MeshPointWifi/MeshPoint/Photos/MeshPoint Winter Test Beta Testing.jpg

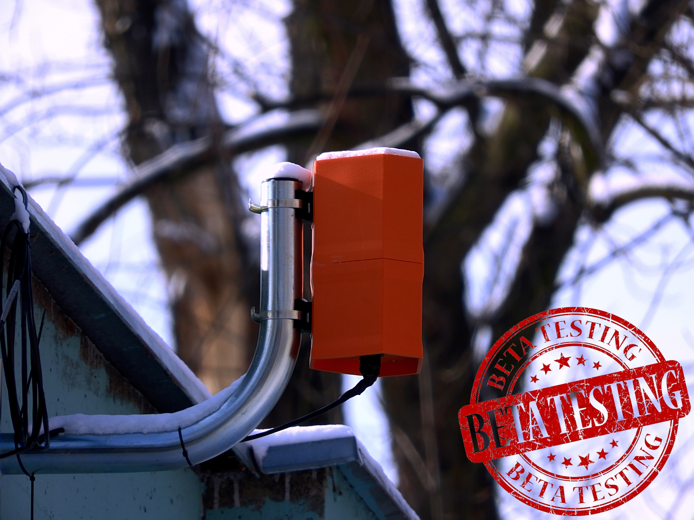
Photos/MeshPoint Winter Test Beta Testing.jpg
