MeshPointWifi/MeshPoint/Photos/Prototype V2/MeshPoint Winter Test Hand Approved.jpg

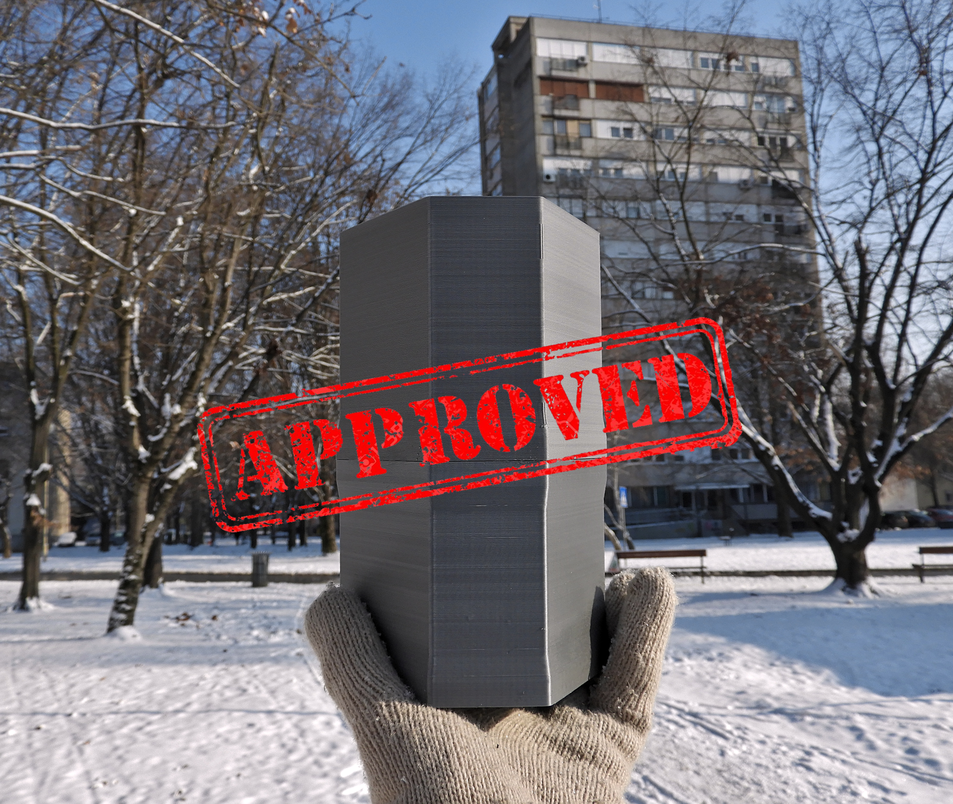
Photos/Prototype V2/MeshPoint Winter Test Hand Approved.jpg
