MeshPointWifi/MeshPoint/README.md

# MeshPoint
MeshPoint is Open source Wifi Hotspot for Crisis Situations
www.meshpointone.com

## Licence

This project (hardware designs, 3D files and documentation) is released under the
**CERN Open Hardware Licence Version 2 - Strongly Reciprocal (CERN-OHL-S v2)**.

See the [LICENCE](LICENCE) file for the full text.
More info: https://cern-ohl.web.cern.ch/
