MeshPointWifi/MeshPoint/Photos/2015-09-20 Tovarnik Refugee Center/20150921_183841.jpg

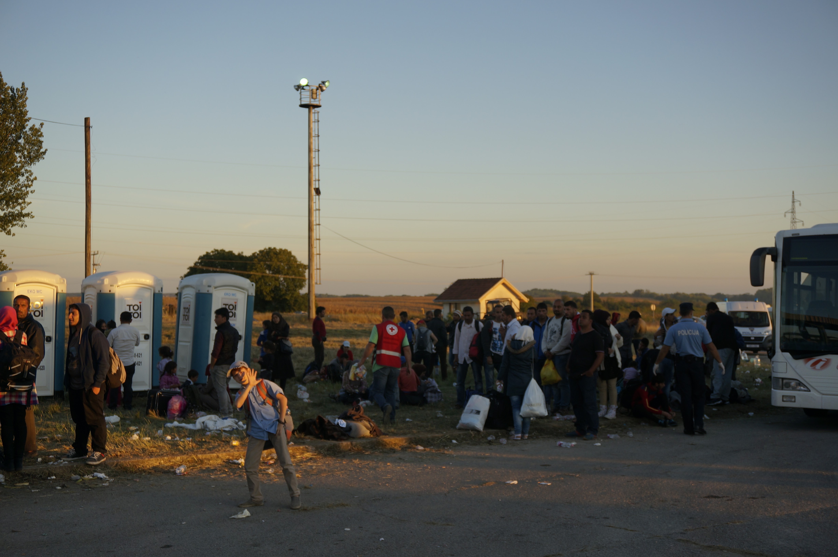
Photos/2015-09-20 Tovarnik Refugee Center/20150921_183841.jpg
