MeshPointWifi/MeshPoint/Photos/2015-09-20 Tovarnik Refugee Center/IMG_3982-COLLAGE.jpg

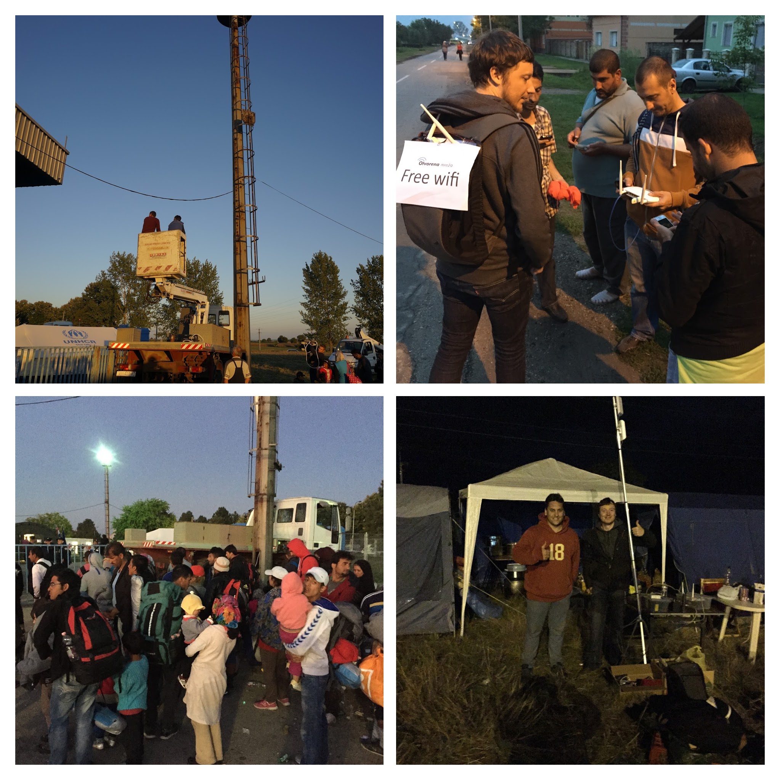
Photos/2015-09-20 Tovarnik Refugee Center/IMG_3982-COLLAGE.jpg
