MeshPointWifi/MeshPoint/Photos/2015-09-20 Tovarnik Refugee Center/IMG_3986.PNG

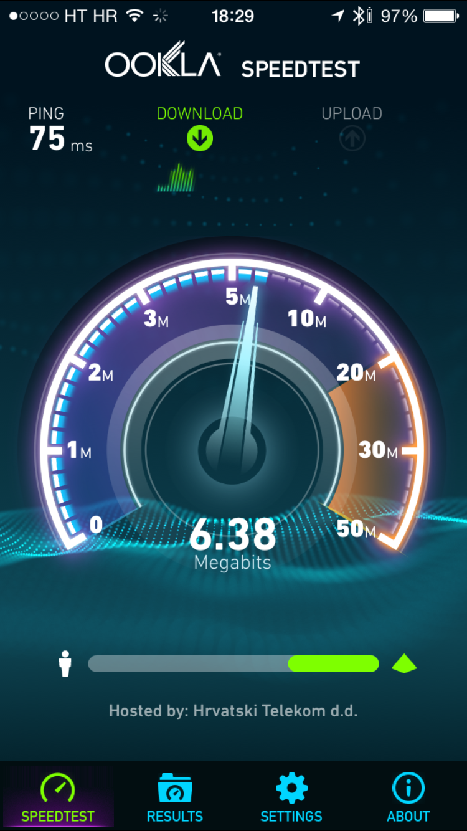
Photos/2015-09-20 Tovarnik Refugee Center/IMG_3986.PNG
