MeshPointWifi/MeshPoint/Photos/2015-09-20 Tovarnik Refugee Center/IMG_4061.JPG

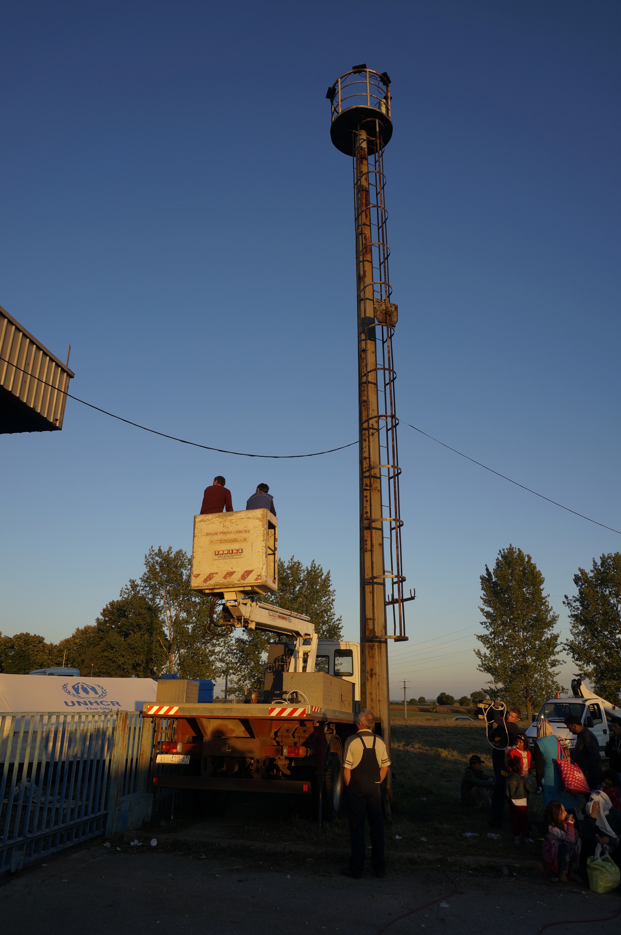
Photos/2015-09-20 Tovarnik Refugee Center/IMG_4061.JPG
