MeshPointWifi/MeshPoint/Photos/2015-09-20 Tovarnik Refugee Center/IMG_20150922_123130.jpg

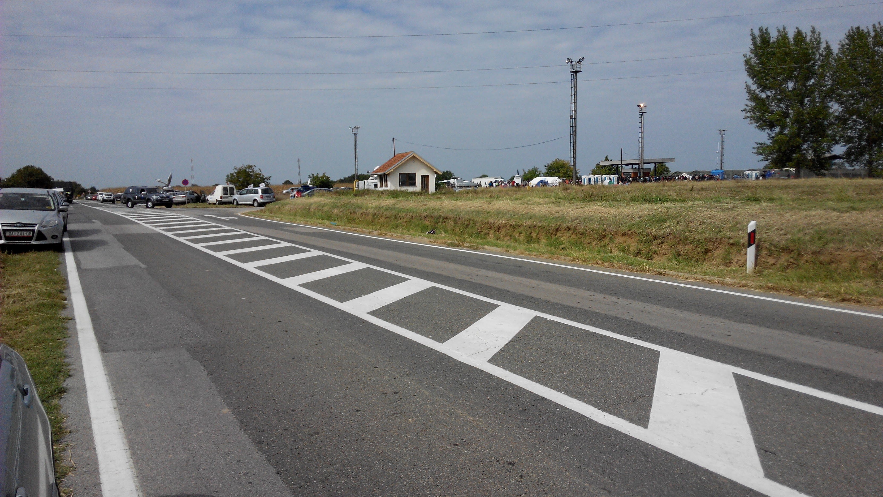
Photos/2015-09-20 Tovarnik Refugee Center/IMG_20150922_123130.jpg
