MeshPointWifi/MeshPoint/Photos/2015-09-20 Tovarnik Refugee Center/opatovac1.jpg

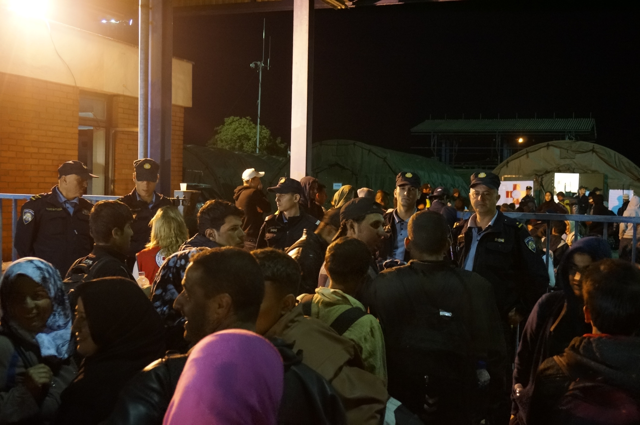
Photos/2015-09-20 Tovarnik Refugee Center/opatovac1.jpg
