MeshPointWifi/MeshPoint/Photos/2015-09-20 Tovarnik Refugee Center/refugee-crisis-cellphone-smartphone-muhammed-muheisen-011.jpg

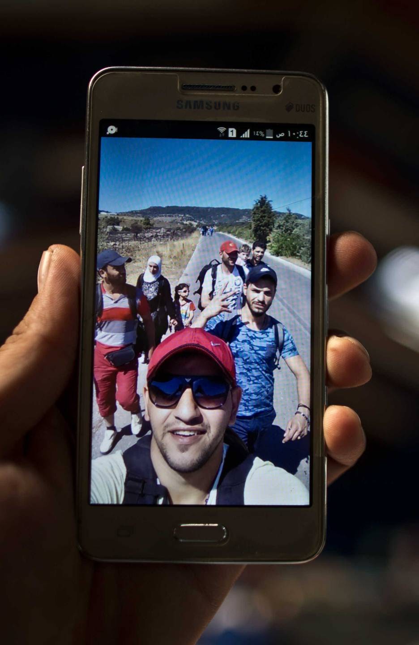
Photos/2015-09-20 Tovarnik Refugee Center/refugee-crisis-cellphone-smartphone-muhammed-muheisen-011.jpg
