MeshPointWifi/MeshPoint/Photos/2015-09-20 Tovarnik Refugee Center/refugee-crisis-patrick-witty-cellphones-005.jpg

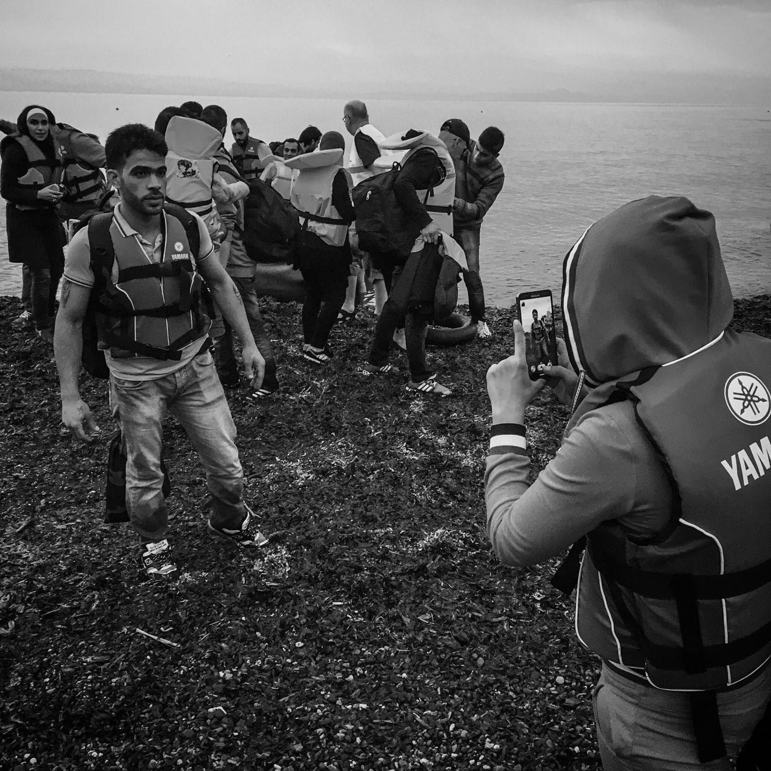
Photos/2015-09-20 Tovarnik Refugee Center/refugee-crisis-patrick-witty-cellphones-005.jpg
