MeshPointWifi/MeshPoint/Photos/2015-09-20 Tovarnik Refugee Center/Tovarnik 1.JPG

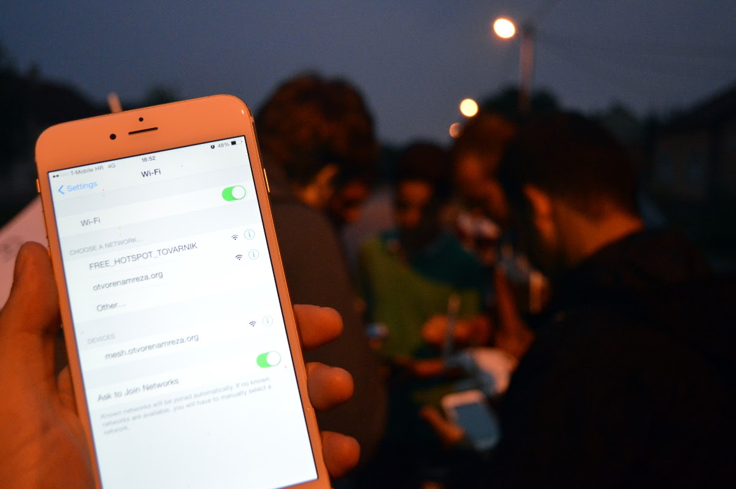
Photos/2015-09-20 Tovarnik Refugee Center/Tovarnik 1.JPG
