MeshPointWifi/MeshPoint/Photos/Europas award for best Humanitarian technology by UNICEF/Photo 14-06-2016, 22 24 03.jpg

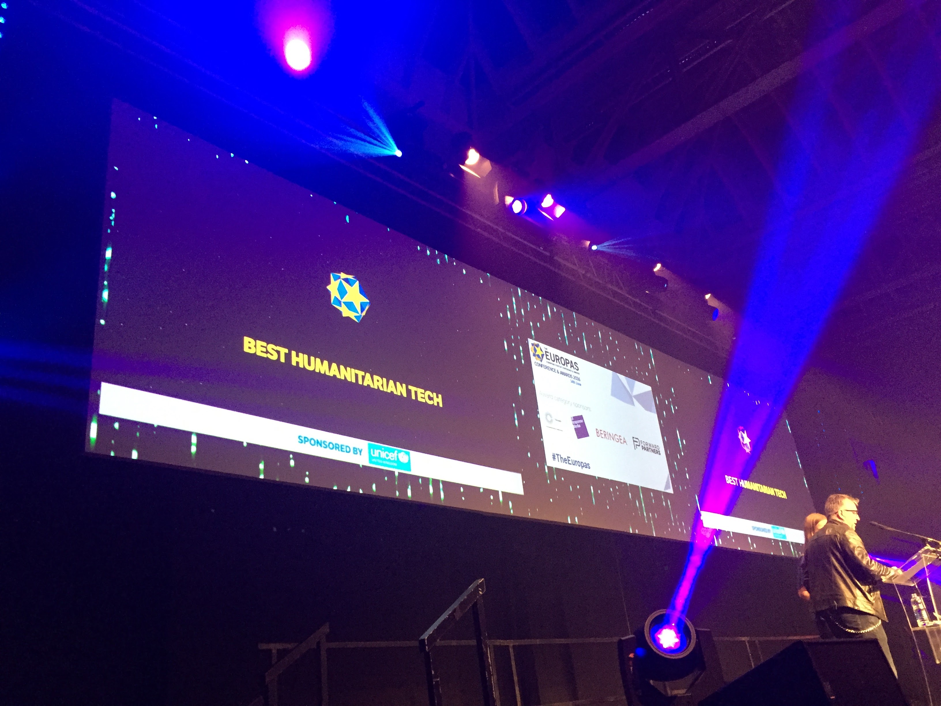
Photos/Europas award for best Humanitarian technology by UNICEF/Photo 14-06-2016, 22 24 03.jpg
