MeshPointWifi/MeshPoint/Photos/Europas award for best Humanitarian technology by UNICEF/Photo 14-06-2016, 22 25 09.jpg

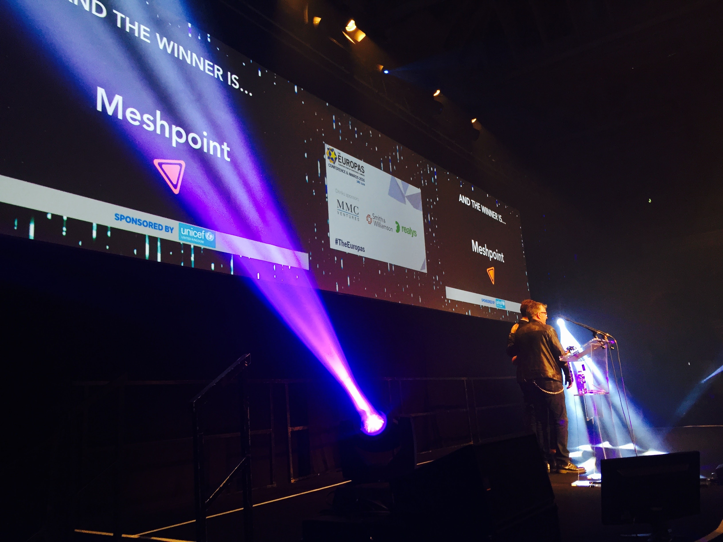
Photos/Europas award for best Humanitarian technology by UNICEF/Photo 14-06-2016, 22 25 09.jpg
