MeshPointWifi/MeshPoint/Photos/Kutija asylum center for underaged children 2017-05-05/IMG_8526.JPG

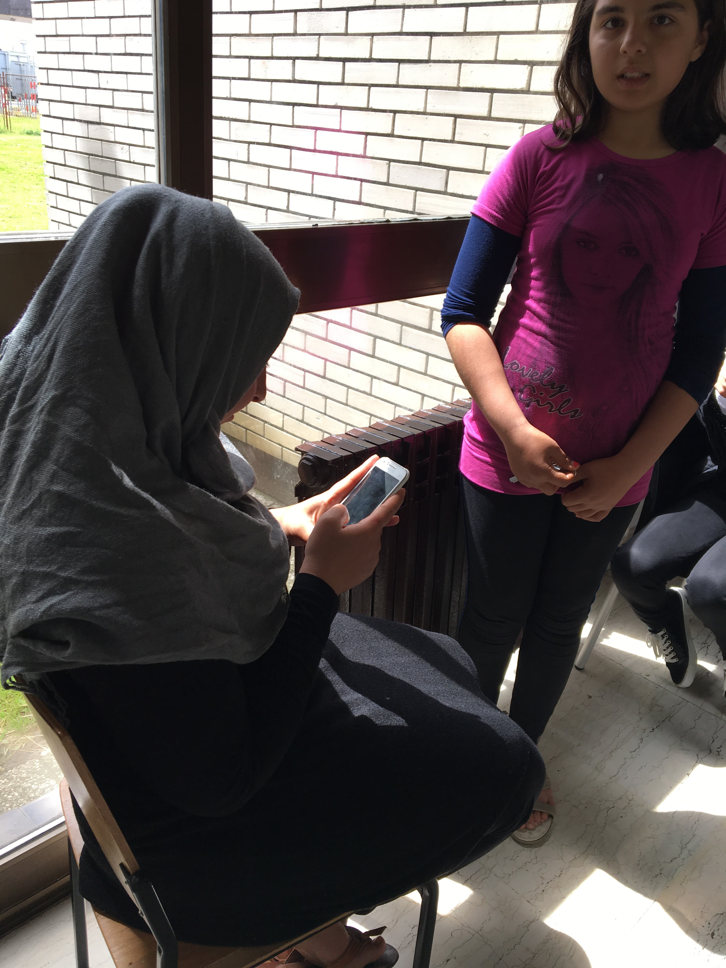
Photos/Kutija asylum center for underaged children 2017-05-05/IMG_8526.JPG
