MeshPointWifi/MeshPoint/Photos/MeshPoint Inside Render.png

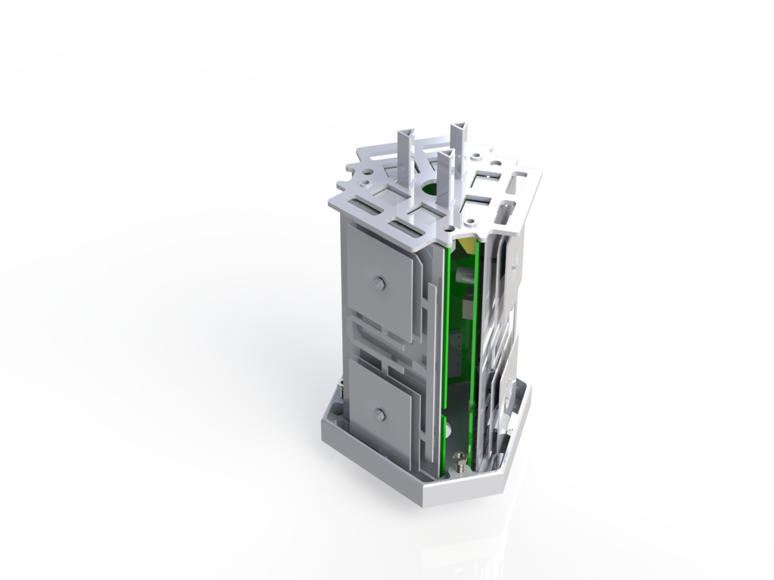
Photos/MeshPoint Inside Render.png
