MeshPointWifi/MeshPoint/Photos/MeshPoint.png

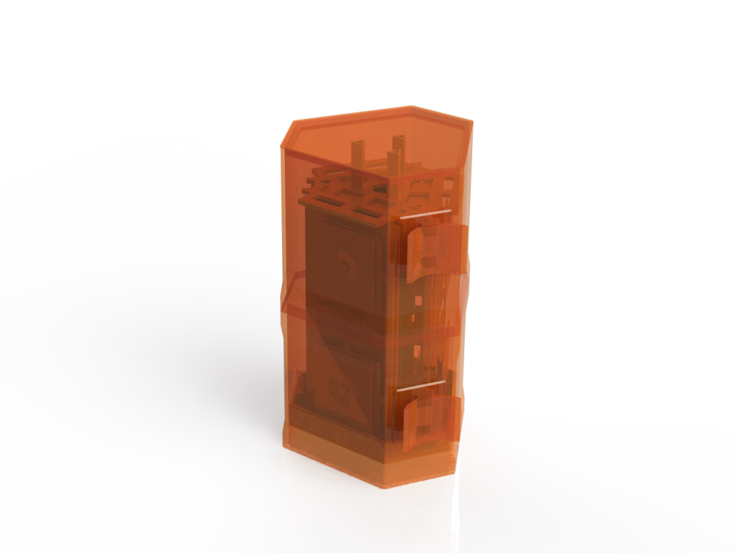
Photos/MeshPoint.png
