MeshPointWifi/MeshPoint/Photos/meshpoint_transparent.png

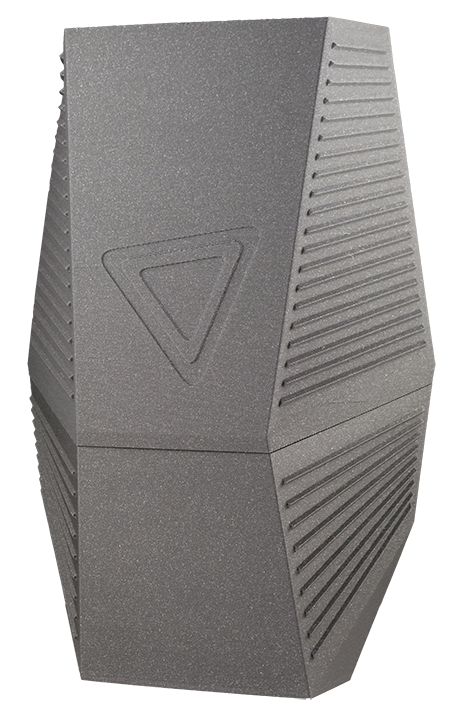
Photos/meshpoint_transparent.png
