MeshPointWifi/MeshPoint/Photos/meshpointV4.png

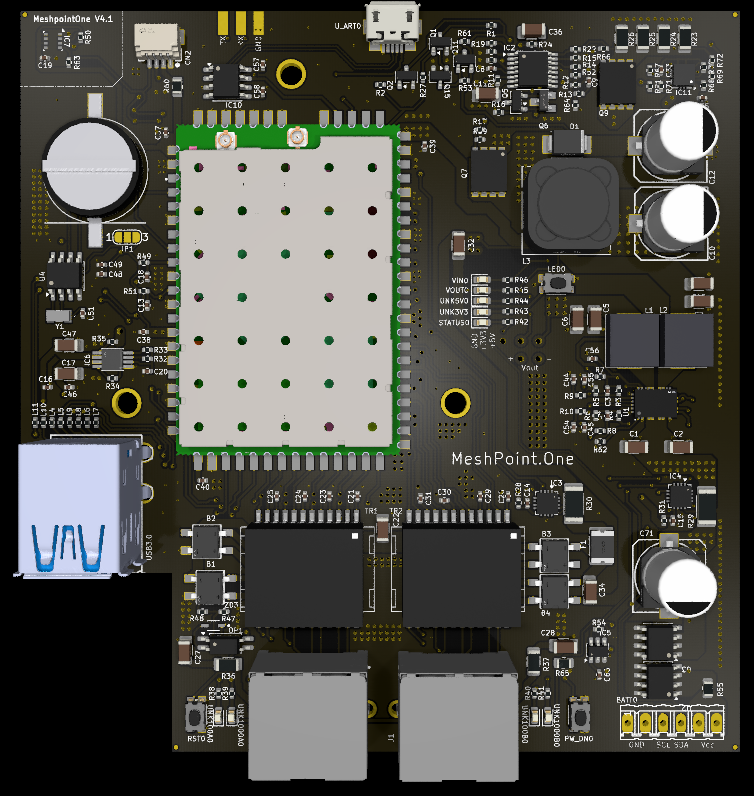
Photos/meshpointV4.png
