MeshPointWifi/MeshPoint/Photos/Prototype V2/IMG_6354.JPG

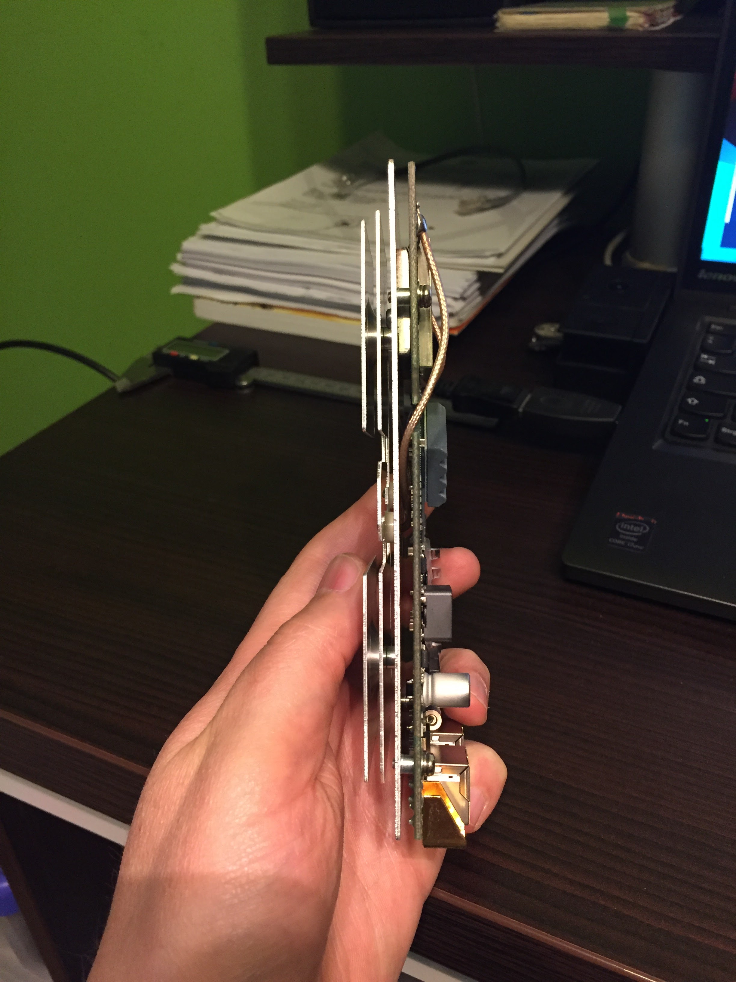
Photos/Prototype V2/IMG_6354.JPG
