MeshPointWifi/MeshPoint/Photos/Prototype V2/IMG_6842.JPG

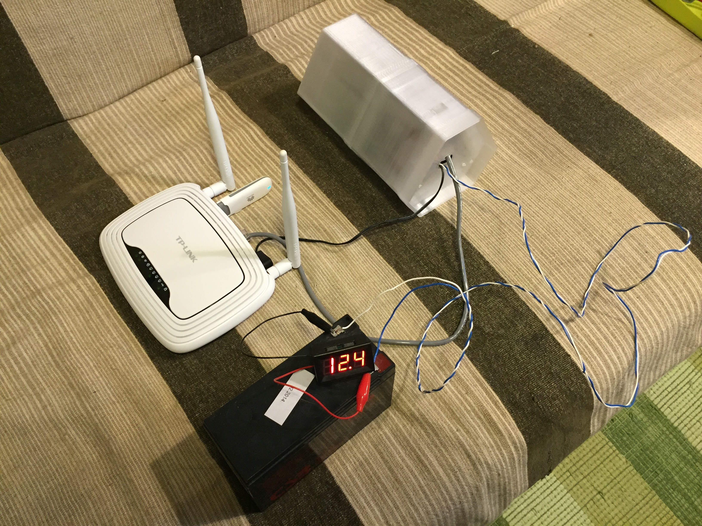
Photos/Prototype V2/IMG_6842.JPG
