MeshPointWifi/MeshPoint/Photos/Prototype V2/IMG_6863.JPG

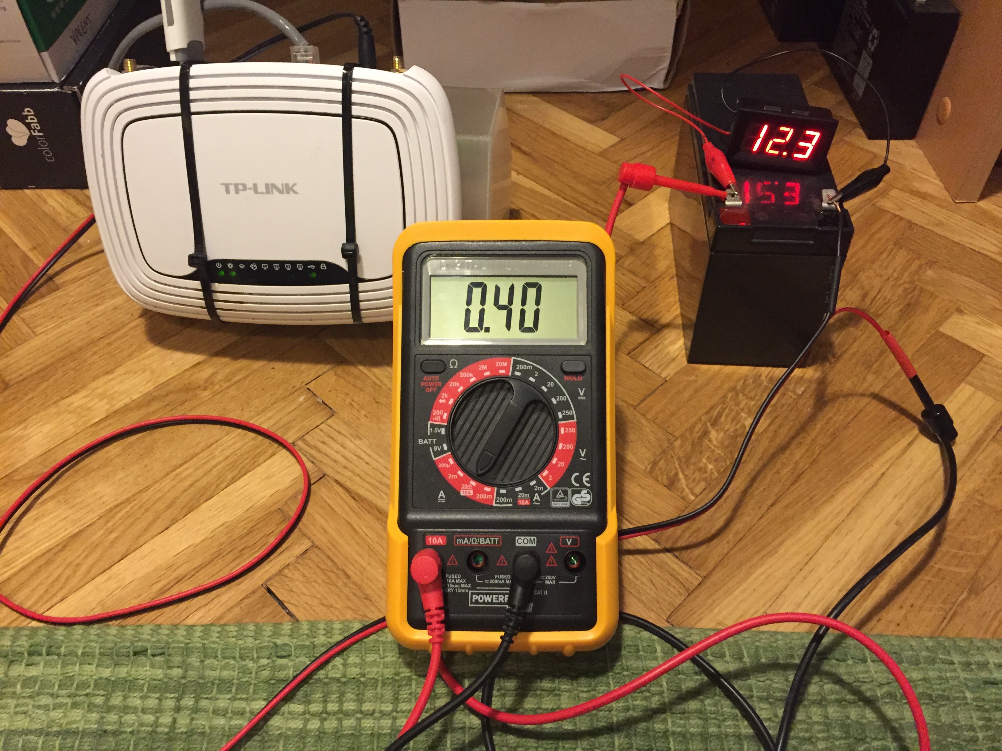
Photos/Prototype V2/IMG_6863.JPG
