MeshPointWifi/MeshPoint/Photos/Prototype V2/IMG_6864.JPG

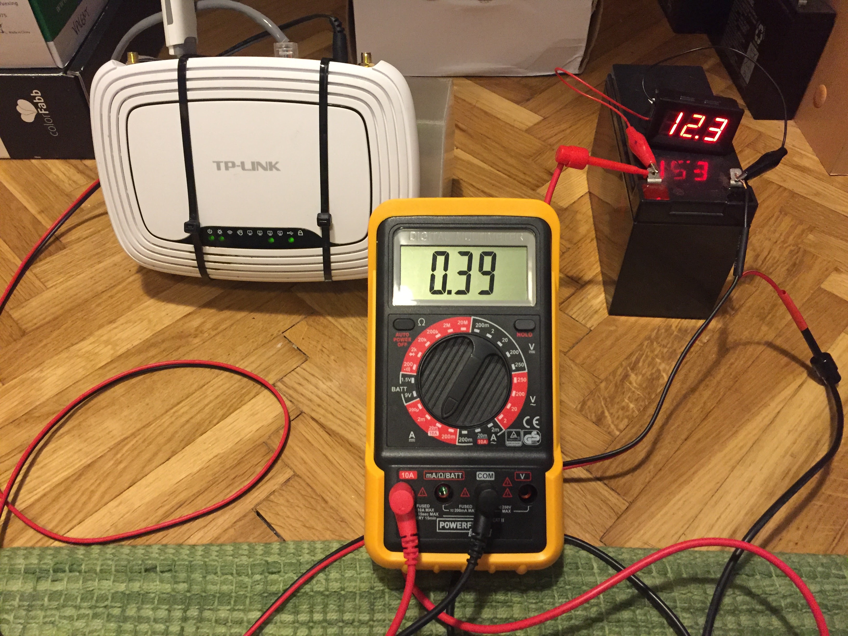
Photos/Prototype V2/IMG_6864.JPG
