MeshPointWifi/MeshPoint/Photos/Prototype V2/IMG_6880 (1).JPG

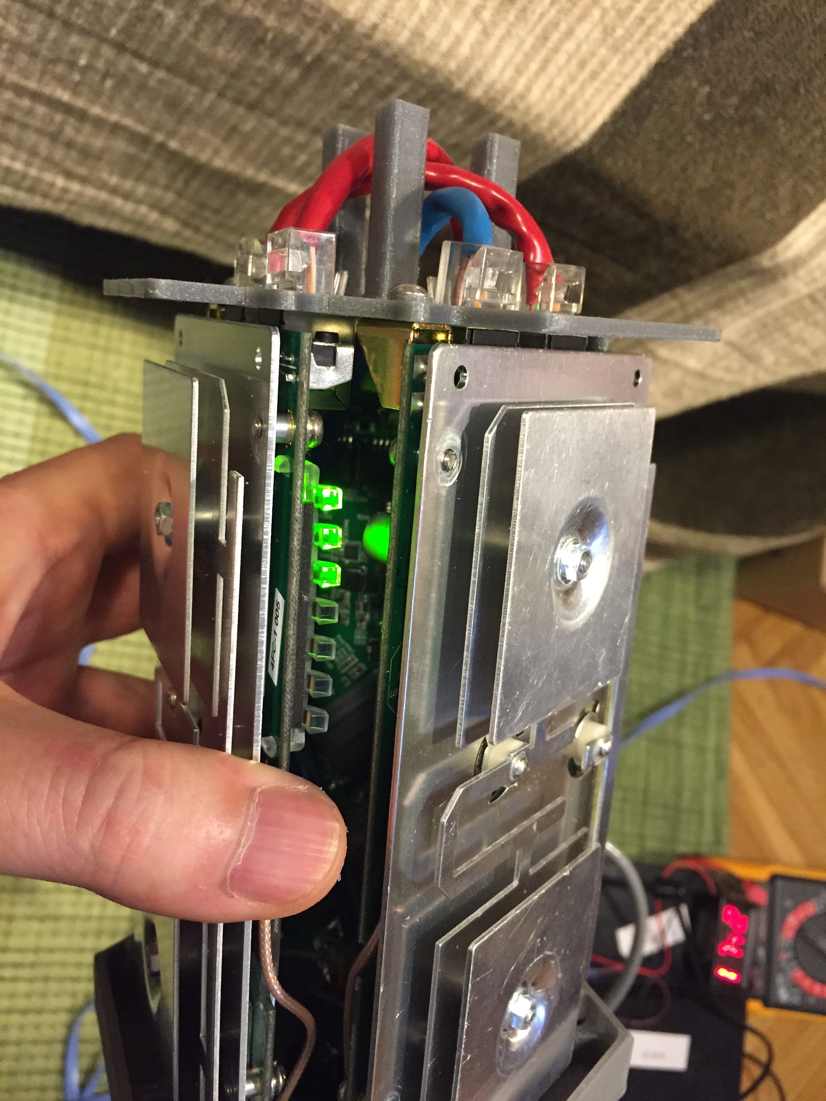
Photos/Prototype V2/IMG_6880 (1).JPG
