MeshPointWifi/MeshPoint/Photos/Prototype V2/IMG_6880.JPG

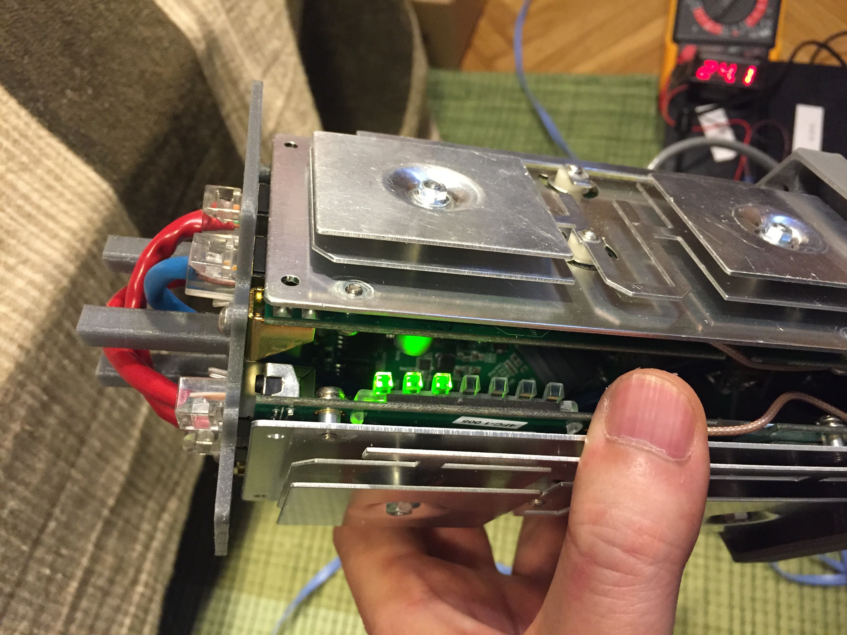
Photos/Prototype V2/IMG_6880.JPG
