MeshPointWifi/MeshPoint/Photos/Prototype V2/MeshPoint Inside.jpg

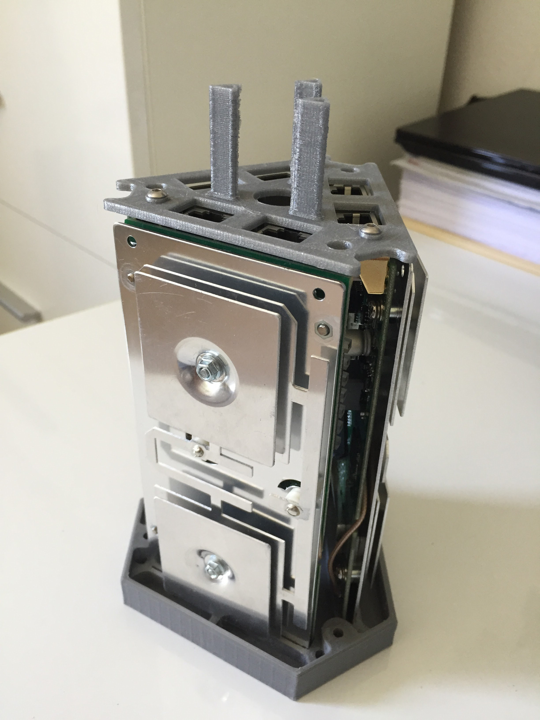
Photos/Prototype V2/MeshPoint Inside.jpg
