MeshPointWifi/MeshPoint/Photos/Prototype V2/MS-03.png

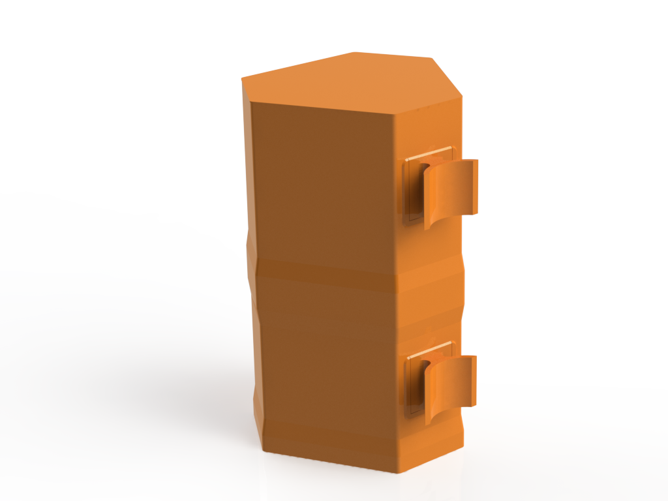
Photos/Prototype V2/MS-03.png
