MeshPointWifi/MeshPoint/Photos/Refugee Center Zagreb Hotel Porin (2016-08-23)/IMG_20160823_141501.jpg

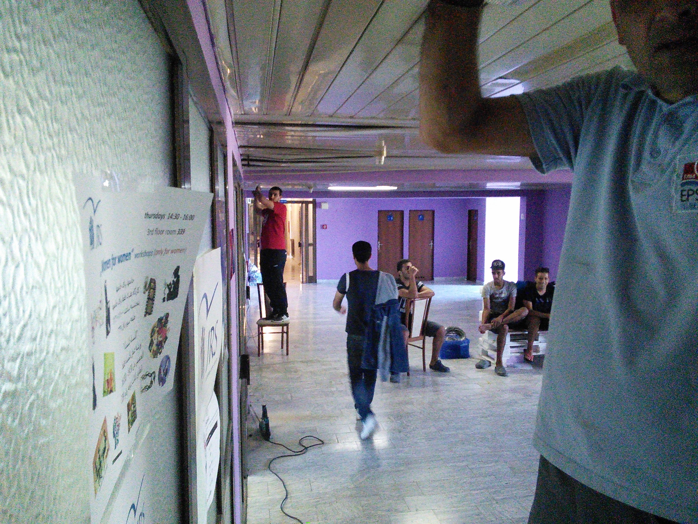
Photos/Refugee Center Zagreb Hotel Porin (2016-08-23)/IMG_20160823_141501.jpg
