MeshPointWifi/MeshPoint/Photos/Slavonski Brod camp shutdown 2016-04-13/12961595_10204571758854438_792094782661609594_n.jpg

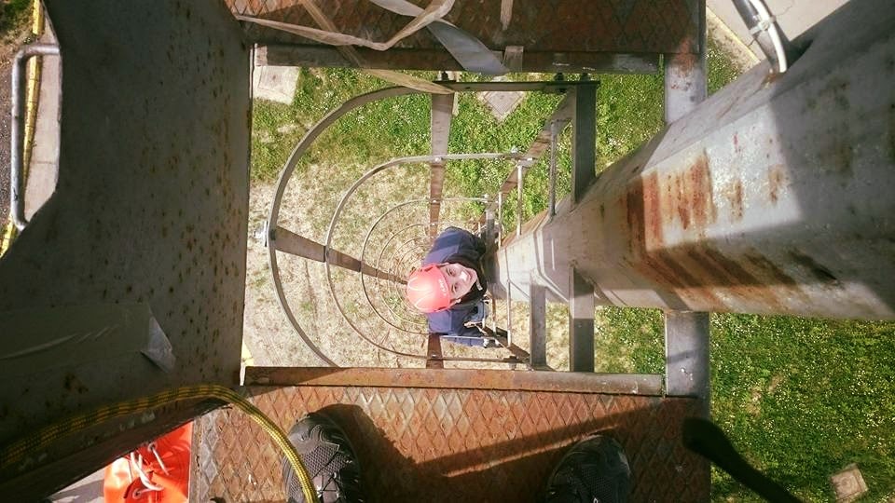
Photos/Slavonski Brod camp shutdown 2016-04-13/12961595_10204571758854438_792094782661609594_n.jpg
