MeshPointWifi/MeshPoint/Photos/Slavonski Brod camp shutdown 2016-04-13/IMG_5903.JPG

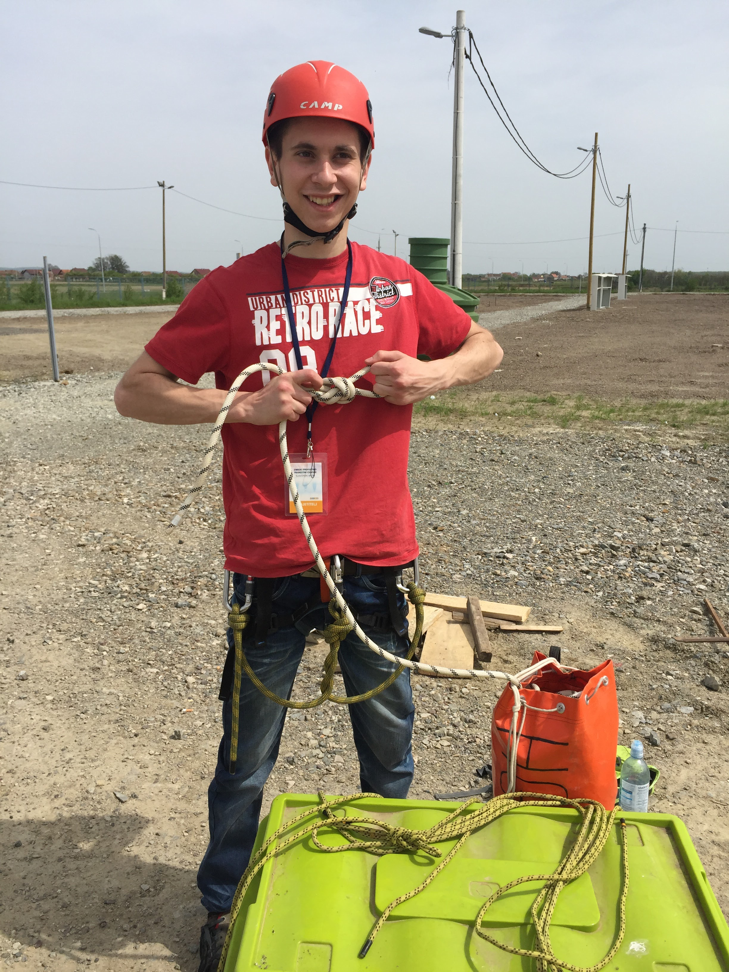
Photos/Slavonski Brod camp shutdown 2016-04-13/IMG_5903.JPG
