MeshPointWifi/MeshPoint/Photos/Techfugees London 2016-12-02/IMG_4668.JPG

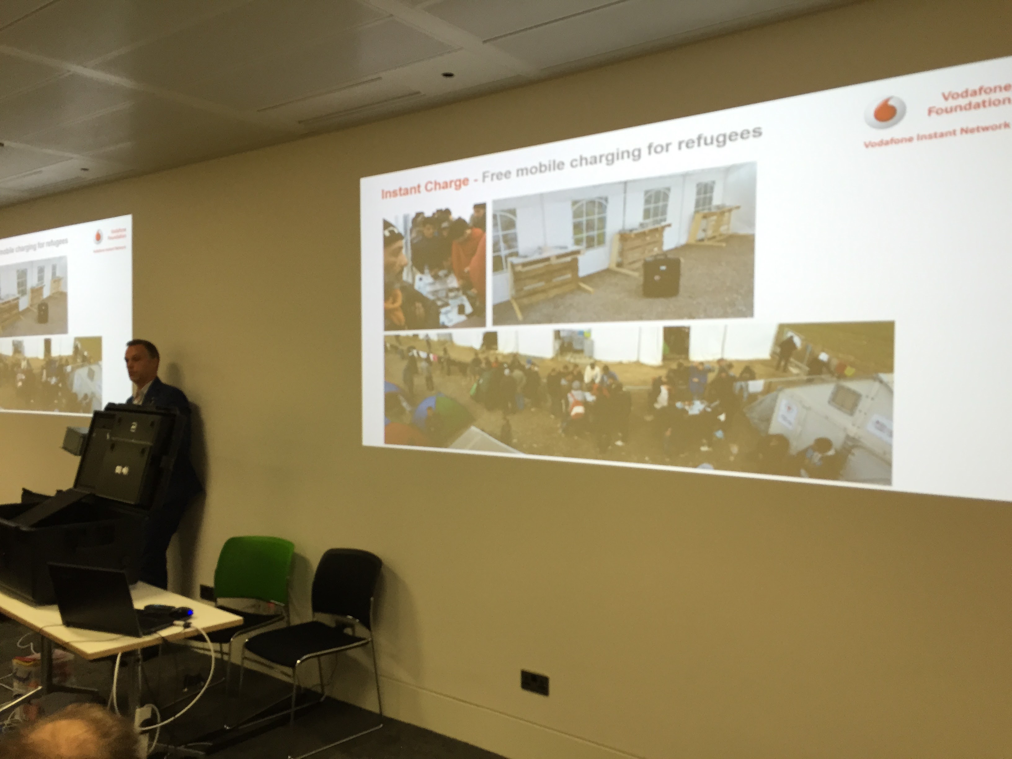
Photos/Techfugees London 2016-12-02/IMG_4668.JPG
