MeshPointWifi/MeshPoint/Photos/Techfugees London 2016-12-02/IMG_4669.JPG

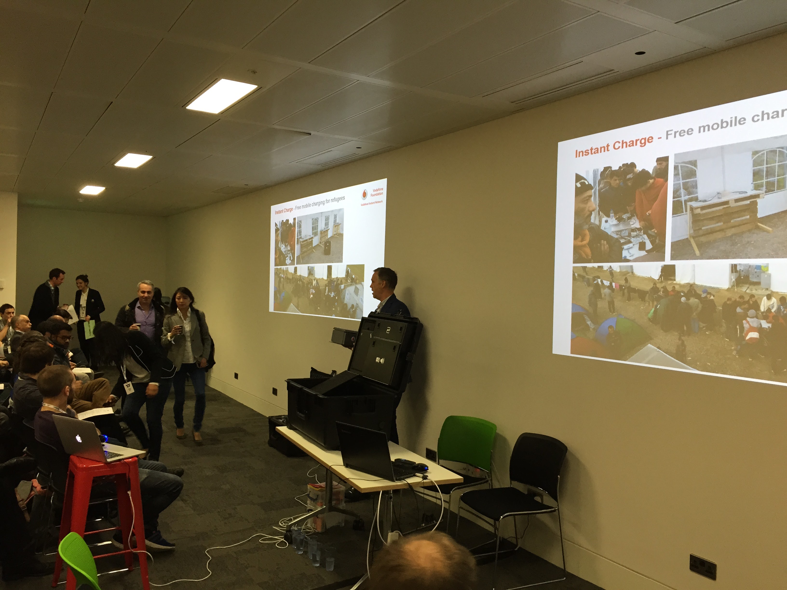
Photos/Techfugees London 2016-12-02/IMG_4669.JPG
