MeshPointWifi/MeshPoint/PCB/KiCad/MeshPoint.One/production/MeshpointOne_v4.1_bom.csv

Designator | Footprint | Quantity | Value | LCSC Part #
B1, B2, B3, B4 | MBS | 4 | 1A/50V | C2488
BATT1 | BATERIJA12MM | 1 | BATTCR1220 | C70377
C1, C2 | 1206 | 2 | 4.7uF | C29823
C10, C12, C71 | 153CLV-1010 | 3 | 220u/35V | C178562
C11, C17, C22, C32, C34, C47 | 1206 | 6 | 10u/35V | C13585
C13, C18 | 0402 | 2 | 100p/35V | C1546
C14, C15, C35, C66 | 0402 | 4 | 1u/35V | C307413
C16, C19, C20, C21, C23, C24, C25, C26, C29, C30, C31, C40, C46, C48, C49, C57, C58 | 0402 | 17 | 100n/35V | C187828
C27, C28 | 1206 | 2 | 10n/600V | C107201
C3, C4 | 0402 | 2 | 4.7pF | C1569
C33, C8, C9 | 0402 | 3 | 10n/35V | C1524
C36 | 1206 | 1 | 47u/10V | C5448950
C37, C38, C39 | 0402 | 3 | 100n | C187828
C42, C5, C6, C7 | 1206 | 4 | 47uF | C96123
C44, C45 | 0402 | 2 | 220pF | C1530
C51 | 0402 | 1 | 22pF | C1555
C54, C55 | 0402 | 2 | 10nF | C1524
C56 | 0402 | 1 | 1uF | C307413
CN2 | EASYC | 1 | EASYC | C160404
D1 | SMB | 1 | B140-13-F | C134426
F1 | 1812 | 1 | 2A | C70124
IC10 | SOIC-8_3.9x4.9mm_P1.27mm | 1 | CH340N | C2977777
IC11 | Texas_DRC0010J | 1 | TPS26623DRCR | C2155839
IC2 | TSSOP-16_4.4x5mm_P0.65mm | 1 | TL494CPWR | C22396897
IC3, IC4 | QFN-16-1EP_3x3mm_P0.5mm_EP1.7x1.7mm | 2 | INA230_RGT_16 | C882784
IC5 | TSOT-23-6 | 1 | LTC4412 | C514442
IC6 | DGN8_1P89X1P57 | 1 | TPS2052B_DGN | C2879167
J1, J2 | SS60300079 | 2 | SS-60300-079 | C402283
L1, L2 | INDC6932X320 | 2 | PA4333.102NLTPA4333.102NLT | C5151941
L10, L11, L4, L5, L6, L7, L8, L9 | 0402 | 8 | 1nH | C19633897
L3 | L_12x12mm_H6mm | 1 | 22uH/1A | C2879697
LED0 | TACTILE_SWITCH_SMD_4.6X2.8MM_535 | 1 | MOMENTARY-SWITCH-SPST-SMD-4.6X2.8MM | C72443
OP1 | SOP-4_4.4x2.6mm_P1.27mm | 1 | TLP283 | C55144
PW_DN0 | TACTILE_SWITCH_SMD_4.6X2.8MM_535 | 1 | PW_DN | C72443
Q1, Q15, Q2, Q5 | SOT-23 | 4 | BC847 | C8664
Q11 | SOT-23 | 1 | SQ2319 | C3280190
Q6 | SOT23-BEC | 1 | BC857 | C8549
Q7, Q9 | PG-TDSON-8 | 2 | IRFH7932TRPBF | C51908847
R1, R32, R33, R45, R50, R53, R59, R61, R63, R66, R73 | 0402 | 11 | 10k | C25744
R10, R62, R9 | 0402 | 3 | 15k | C25756
R11, R34, R35 | 0402 | 3 | 3.3k | C25890
R12 | 0402 | 1 | 150k | C25755
R13 | 0402 | 1 | 27K | C25771
R14, R52, R64 | 0402 | 3 | 51K | C25794
R15, R22, R46, R48 | 0402 | 4 | 2K2 | C25879
R16, R20, R21 | 0402 | 3 | 1K | C11702
R17 | 0402 | 1 | 10R | C25077
R19 | 0402 | 1 | 8K2 | C137929
R2, R27, R49, R51 | 0402 | 4 | 4.7K | C25900
R23, R24, R25, R26 | 1206 | 4 | 1R | C17928
R28, R31 | 0402 | 2 | 1R | C25086
R29, R30 | 2010 | 2 | 2mR | C844078
R3, R4 | 0402 | 2 | 1M | C279988
R36, R37 | 1206 | 2 | 75R | C17987
R38, R39, R40, R41, R43 | 0402 | 5 | 330R | C25104
R42, R44, R47 | 0402 | 3 | 470R | C25117
R5 | 0402 | 1 | 191k | C852583
R54, R74 | 0402 | 2 | 470K | C25799
R55, R60, R65 | 0805 | 3 | 0R | C17477
R6 | 0402 | 1 | 316k | C25777
R67 | 0402 | 1 | 13k3 | C3015832
R68 | 0402 | 1 | 715k | C5126240
R69 | 0402 | 1 | 22K | C25768
R7, R71, R72, R8 | 0402 | 4 | 100k | C25741
R70 | 0402 | 1 | 33K | C25779
RST0 | TACTILE_SWITCH_SMD_4.6X2.8MM_535 | 1 | RST | C72443
STATUS0, VOUT0 | 0603 | 2 | BL | C2288
TR1, TR2 | WURTH1000T | 2 | WURTH_TR | C6828534
U$5 | JALAPENO-PCB | 1 | JALAPENO
U1 | QFN50P600X400X103-32N240X440 | 1 | LT8650SEV#PBF | C3198284
U2, U3 | SOIC-8_3.9x4.9mm_P1.27mm | 2 | SI4435DYTRPBF | C67287
U4 | SOIC-8_3.9x4.9mm_P1.27mm | 1 | PCF8563T | C7440
UNK1000A0, UNK1000B0, UNK3V3, UNK5V0, VIN0 | 0603 | 5 | GR | C72043
UNK100A0, UNK100B0 | 0603 | 2 | YL | C72038
USB3.0 | USB3.0D | 1 | USB3.0D
U_ART0 | MOLEX-47364-0001 | 1 | MOLEX-47346-0001 | C232975
Y1 | SC32S125PF20PPM | 1 | SC32S-12.5PF20PPM | C130253
ZD3 | SOD2513X120N | 1 | BZT52C15S | C19077448
