MeshPointWifi/MeshPoint/MeshPoint Case/Inside/Top Triangle.stl

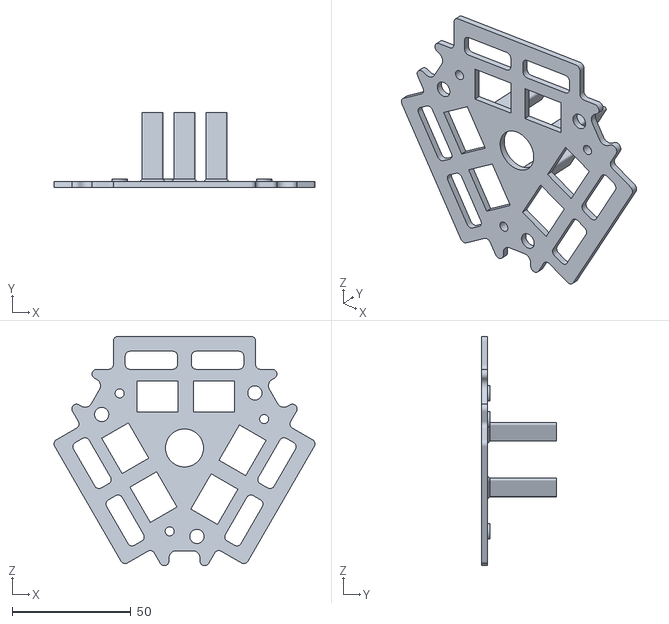
[picture p74: CAD file, 2017-06-12]
MeshPoint Case/Inside/Top Triangle.stl
110.1 x 31.5 x 96.8
