MeshPointWifi/MeshPoint/MeshPoint Case/Mount/Mount.STL

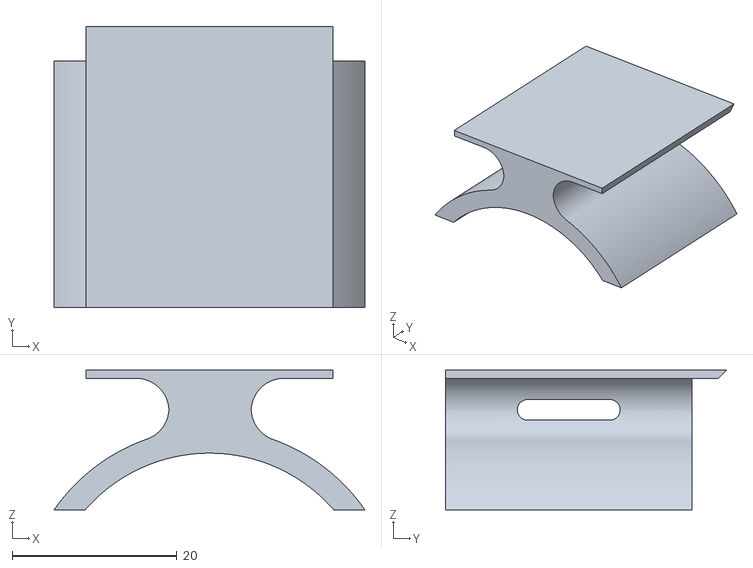
[picture p75: CAD file, 2016-07-12]
MeshPoint Case/Mount/Mount.STL
37.8 x 34.2 x 17.0
