MeshPointWifi/MeshPoint/MeshPoint Case/Shell/1 part shell/Shell-uni.stl

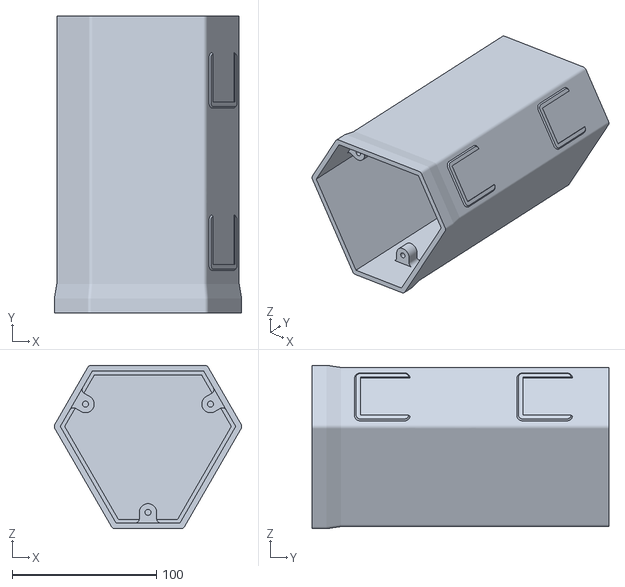
[picture p76: CAD file, 2016-07-12]
MeshPoint Case/Shell/1 part shell/Shell-uni.stl
129.9 x 205.8 x 113.3
