MeshPointWifi/MeshPoint/MeshPoint Case/Shell/2 part shell/Shell-1-duo-support.stl

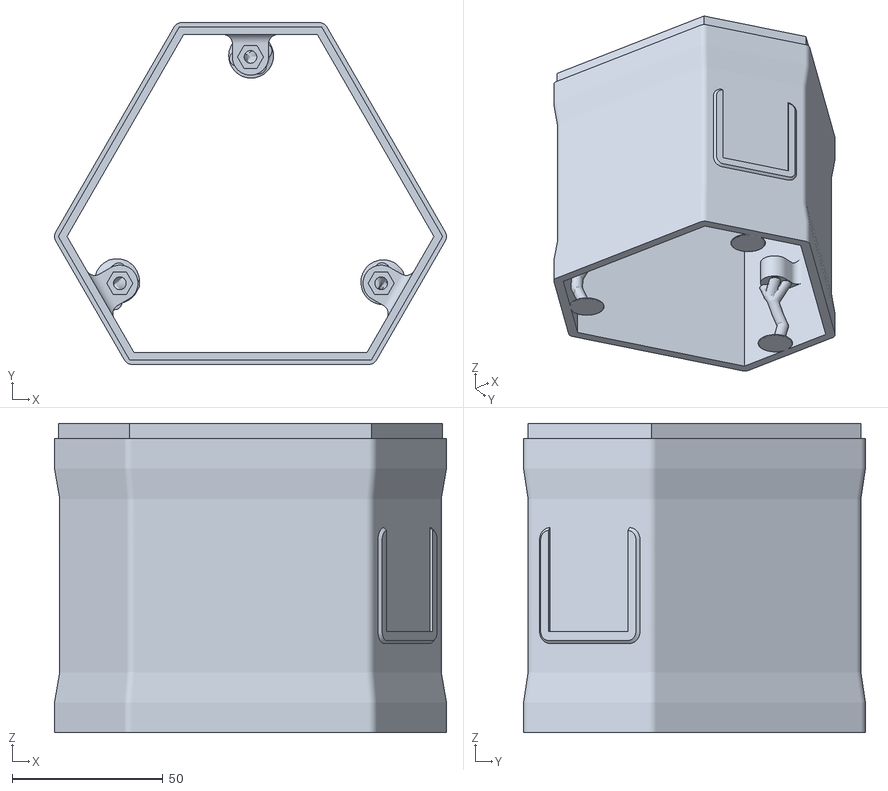
[picture p77: CAD file, 2017-05-22]
MeshPoint Case/Shell/2 part shell/Shell-1-duo-support.stl
129.9 x 113.3 x 102.5
