MeshPointWifi/MeshPoint/MeshPoint Case/Shell/3 part shell/Shell-1-trio.stl

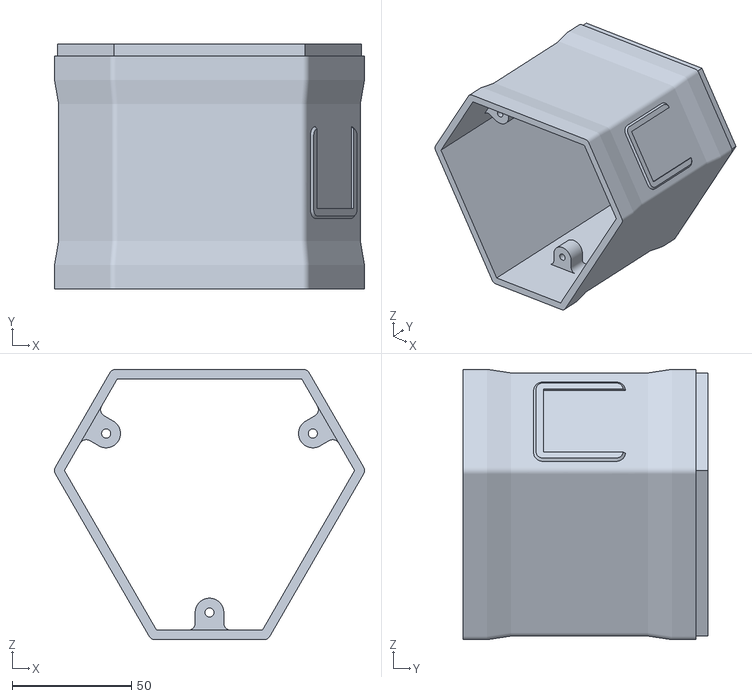
[picture p78: CAD file, 2017-06-12]
MeshPoint Case/Shell/3 part shell/Shell-1-trio.stl
129.9 x 102.5 x 113.3
