MeshPointWifi/MeshPoint/MeshPoint Case/Shell/3 part shell/Shell-3-top-trio.STL

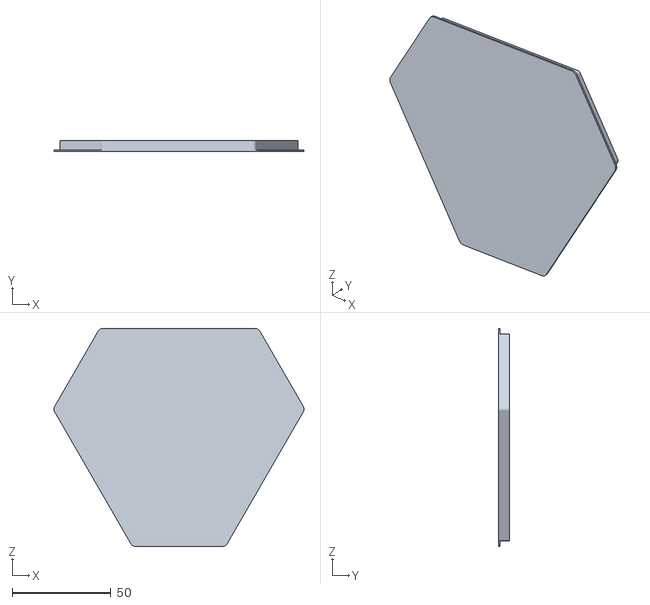
[picture p79: CAD file, 2016-07-12]
MeshPoint Case/Shell/3 part shell/Shell-3-top-trio.STL
126.8 x 5.80 x 110.6
