MeshPointWifi/MeshPoint/(list of files, cad)

Other CAD files:
PCB/KiCad/MeshPoint.One/dxf/meshpoint_hole.dxf
