MeshPointWifi/MeshPoint/PCB/KiCad/MeshPoint.One/MeshPoint.One.pdf

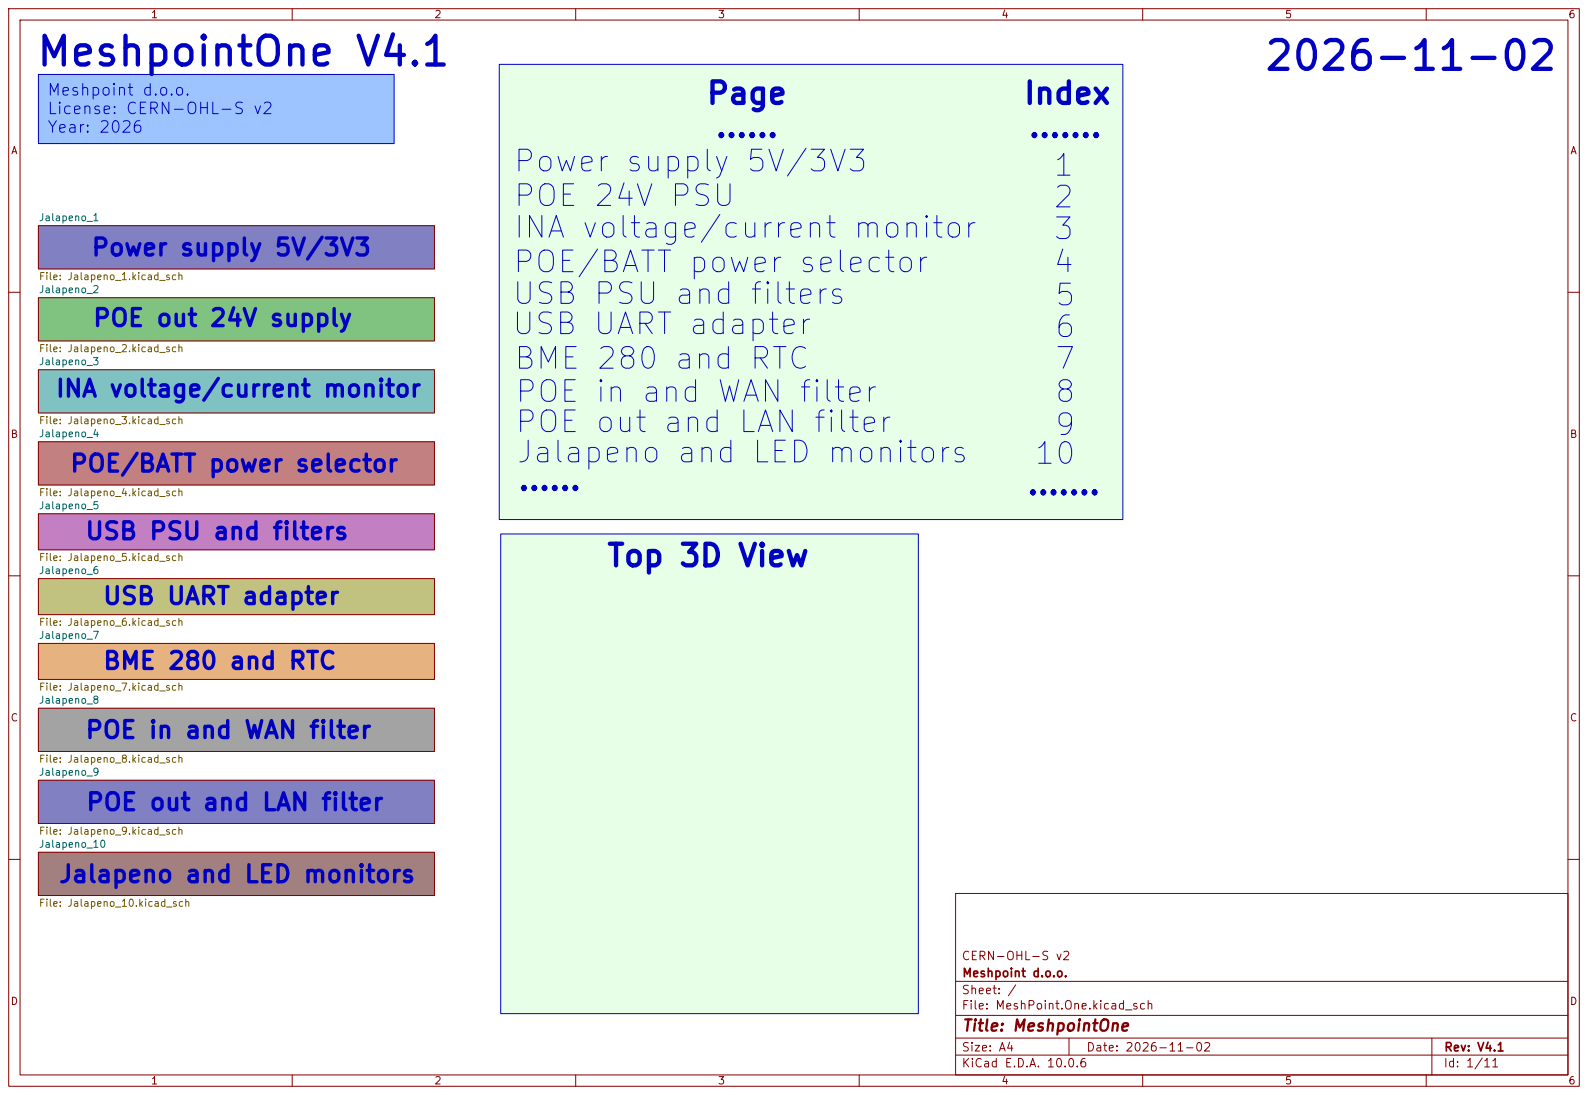
[picture p80: page 1]

....... Jalapeno and LED monitors
Power supply 5V/3V3
POE 24V PSU
INA voltage/current monitor
POE/BATT power selector
USB PSU and filters
USB UART adapter
BME 280 and RTC
POE in and WAN filter
...... POE out and LAN filter

File: Jalapeno_8.kicad_sch
Jalapeno_9
POE out and LAN filter

Size: A4 | Rev: V4.1
KiCad E.D.A. 10.0.6 | Id: 1/11

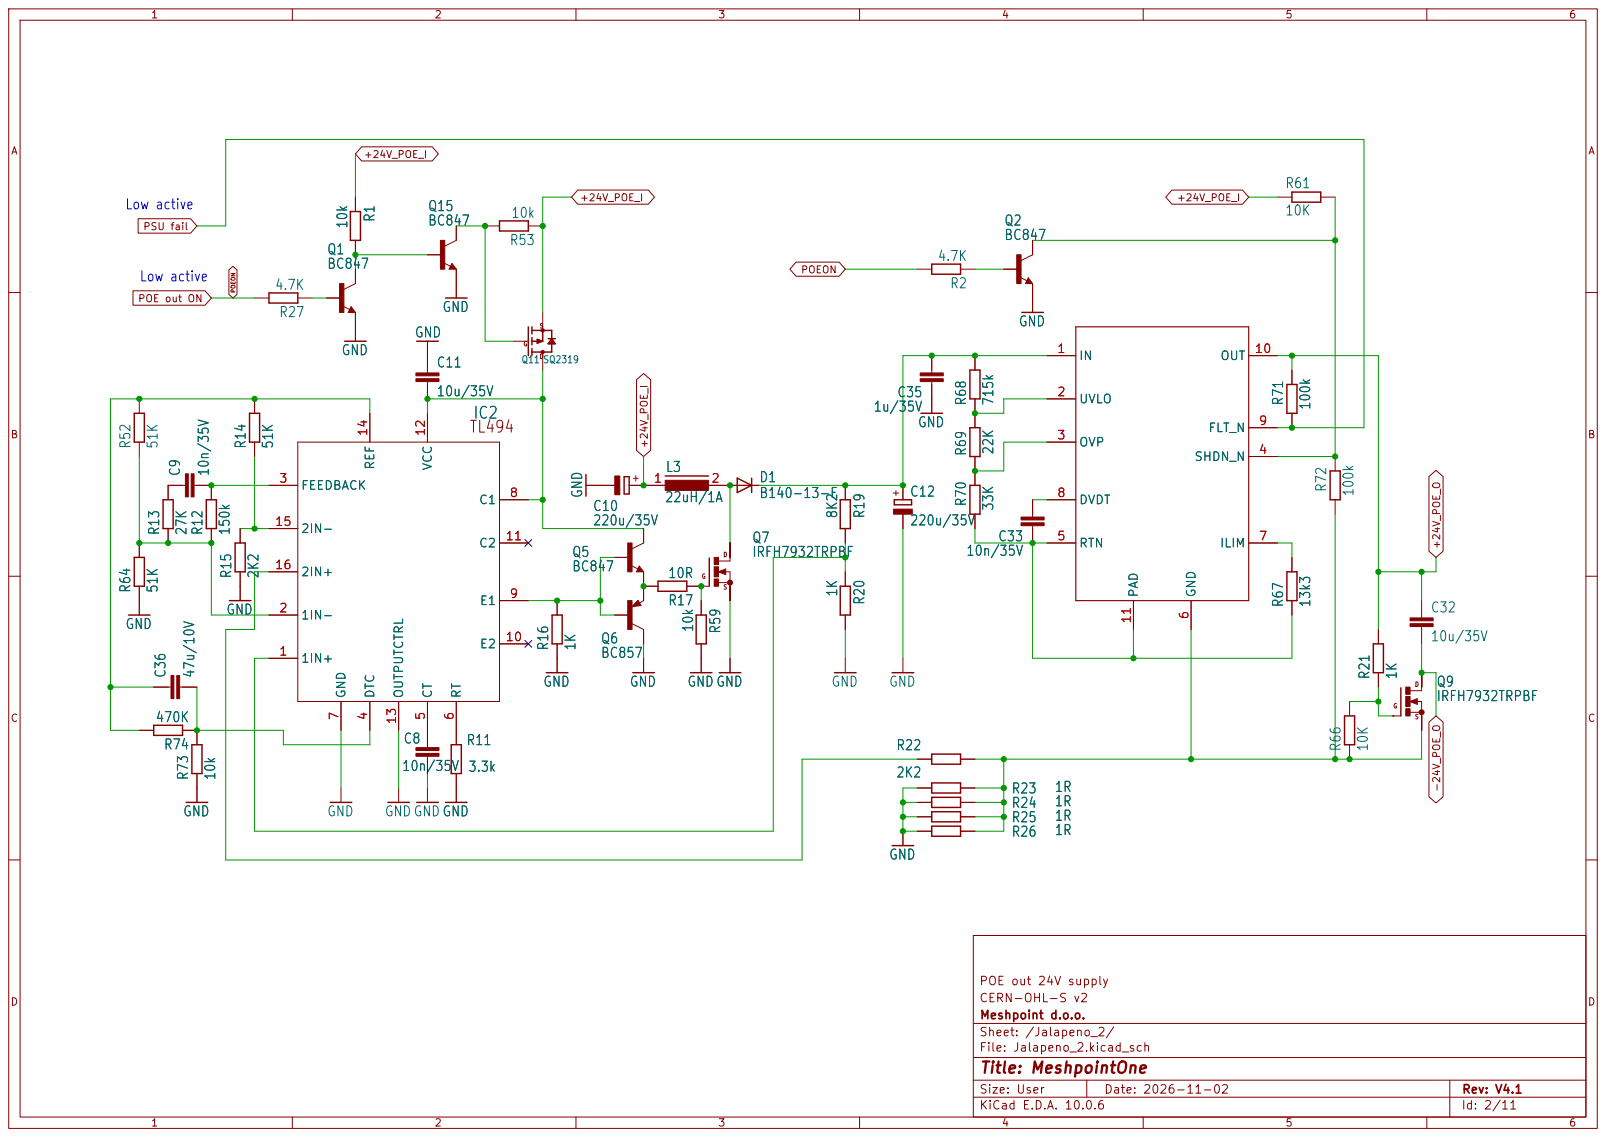
[picture p81: page 2]

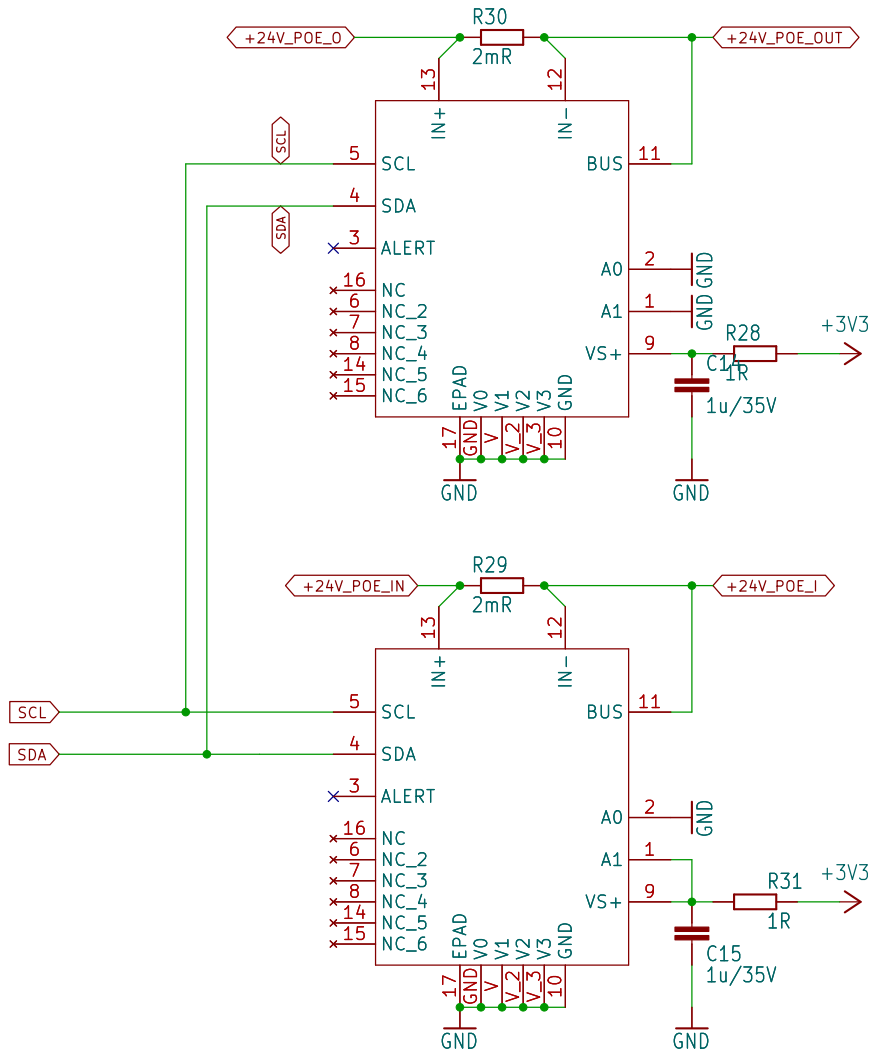
[picture p82: page 3]

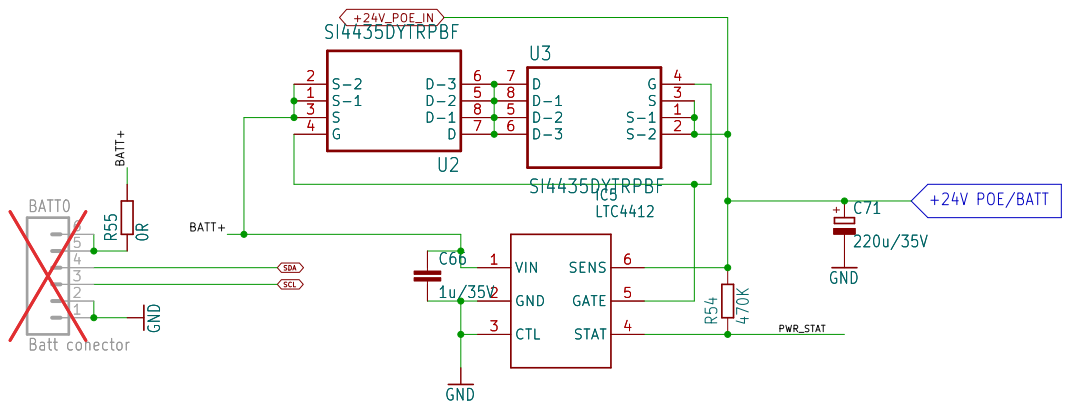
[picture p83: page 4]

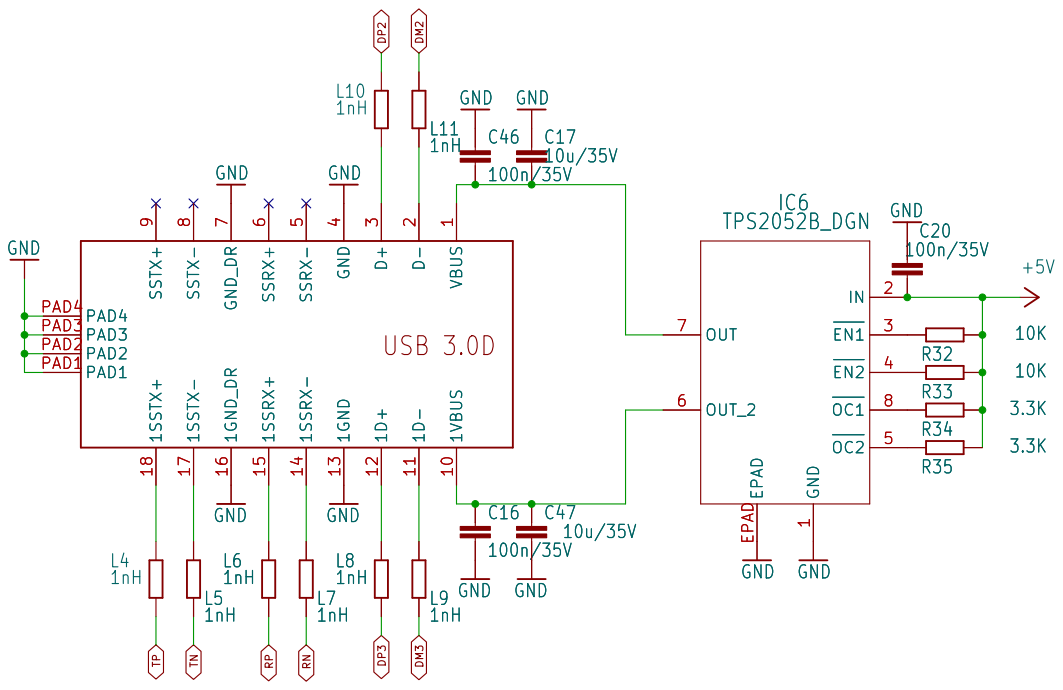
[picture p84: page 5]

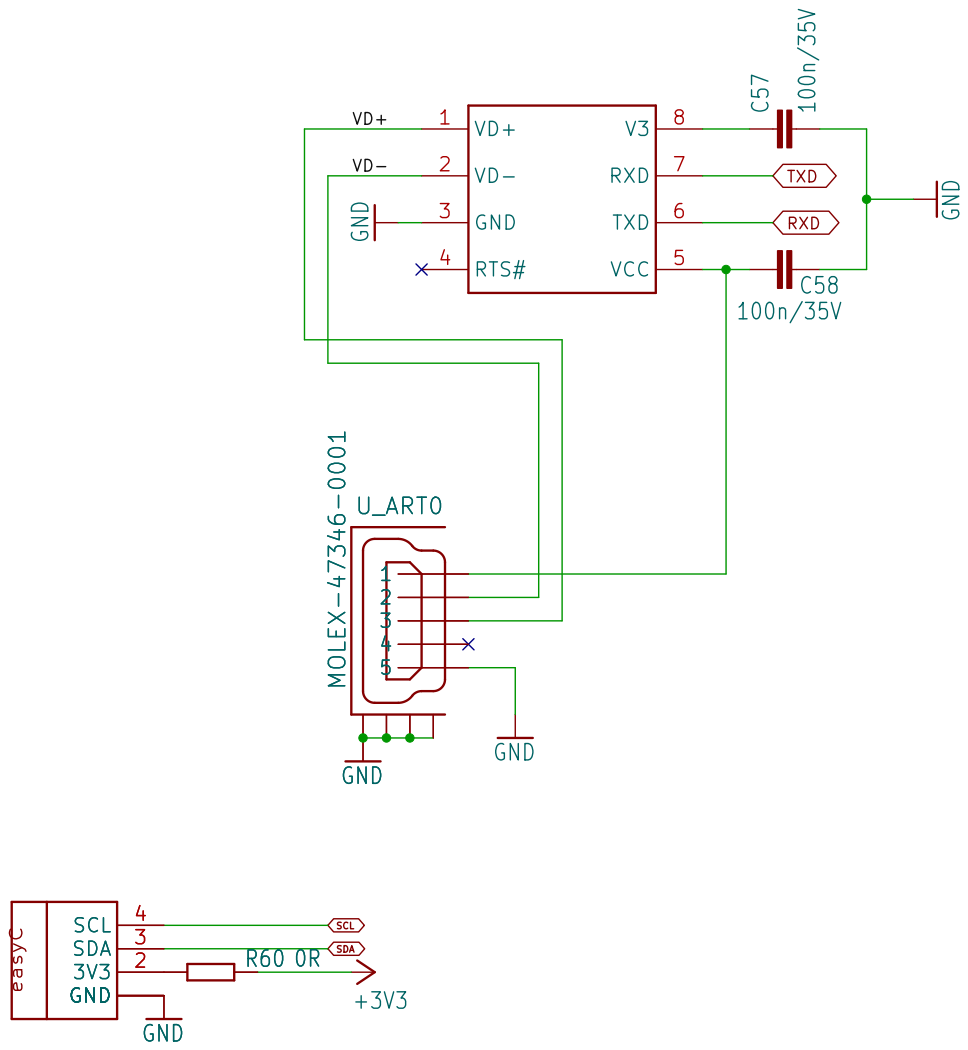
[picture p85: page 6]

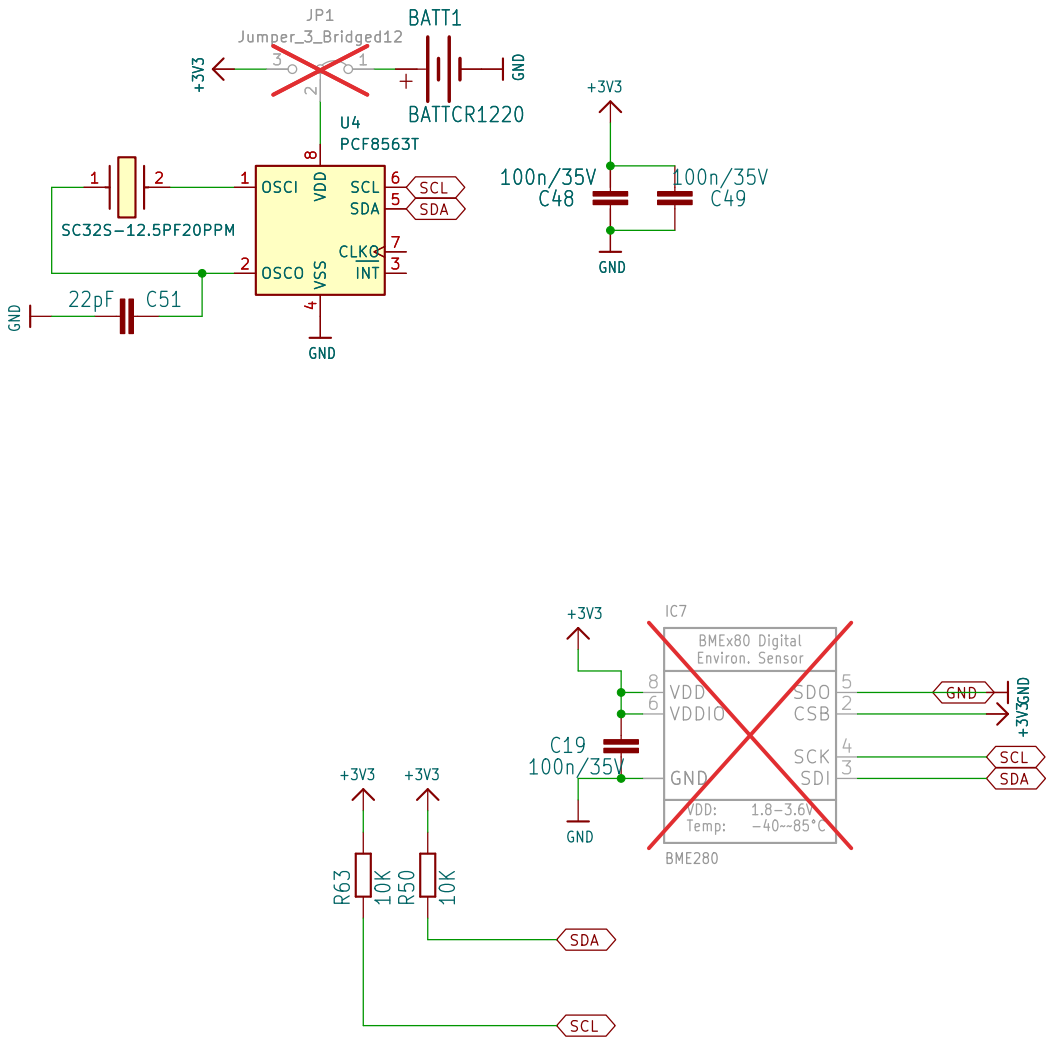
[picture p86: page 7]

VDD: Temp: BMEx80 Digital Environ. Sensor 1.8-3.6V -40~~85°C GND

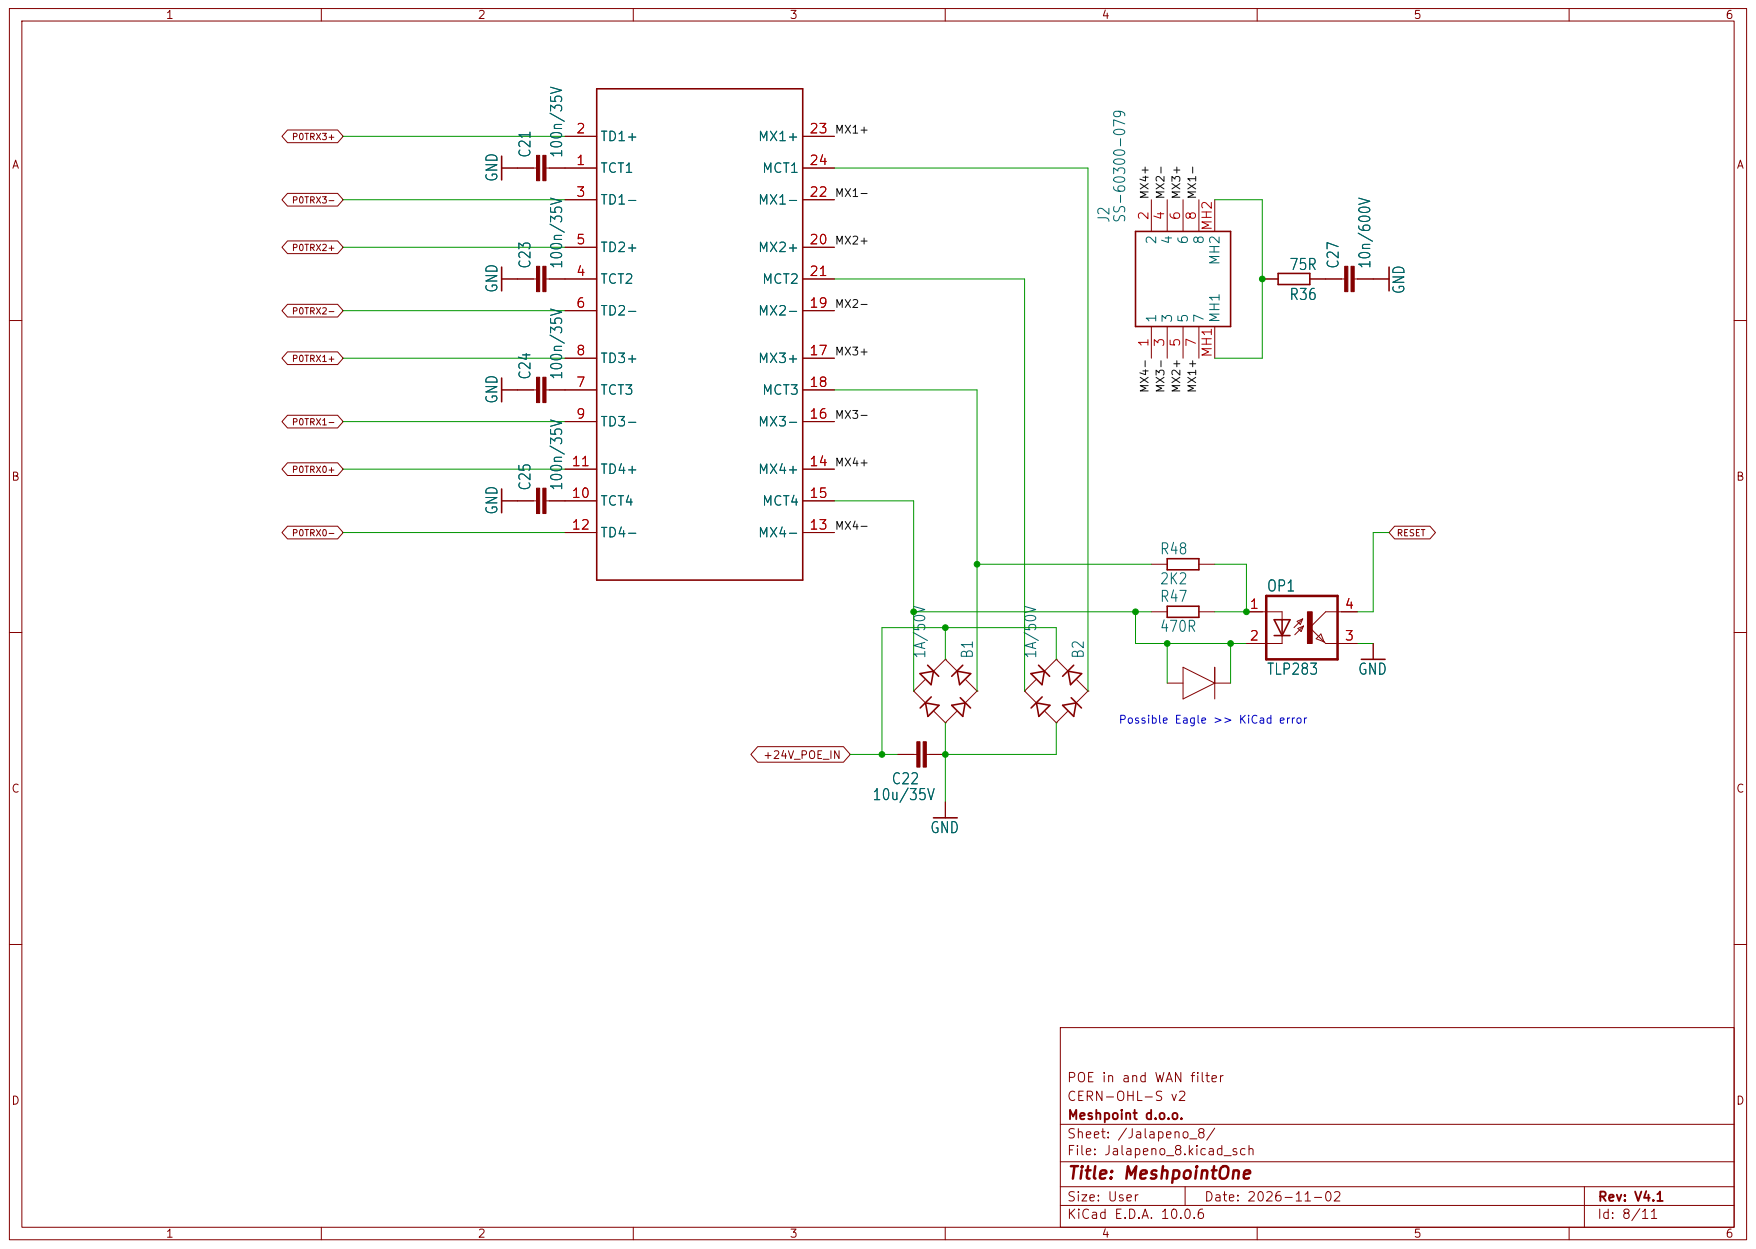
[picture p87: page 8]

Possible Eagle >> KiCad error R36

POE in and WAN filter GND

TD1- 3 TD1- 3 TD2+ 5 TD2+ 5 TCT2 4 TCT2 4 | MX1-MX2+

TD2- 6 TD2- 6 TD3+ 8 TD3+ 8 TCT3 7 TCT3 7 | MX2-MX3+

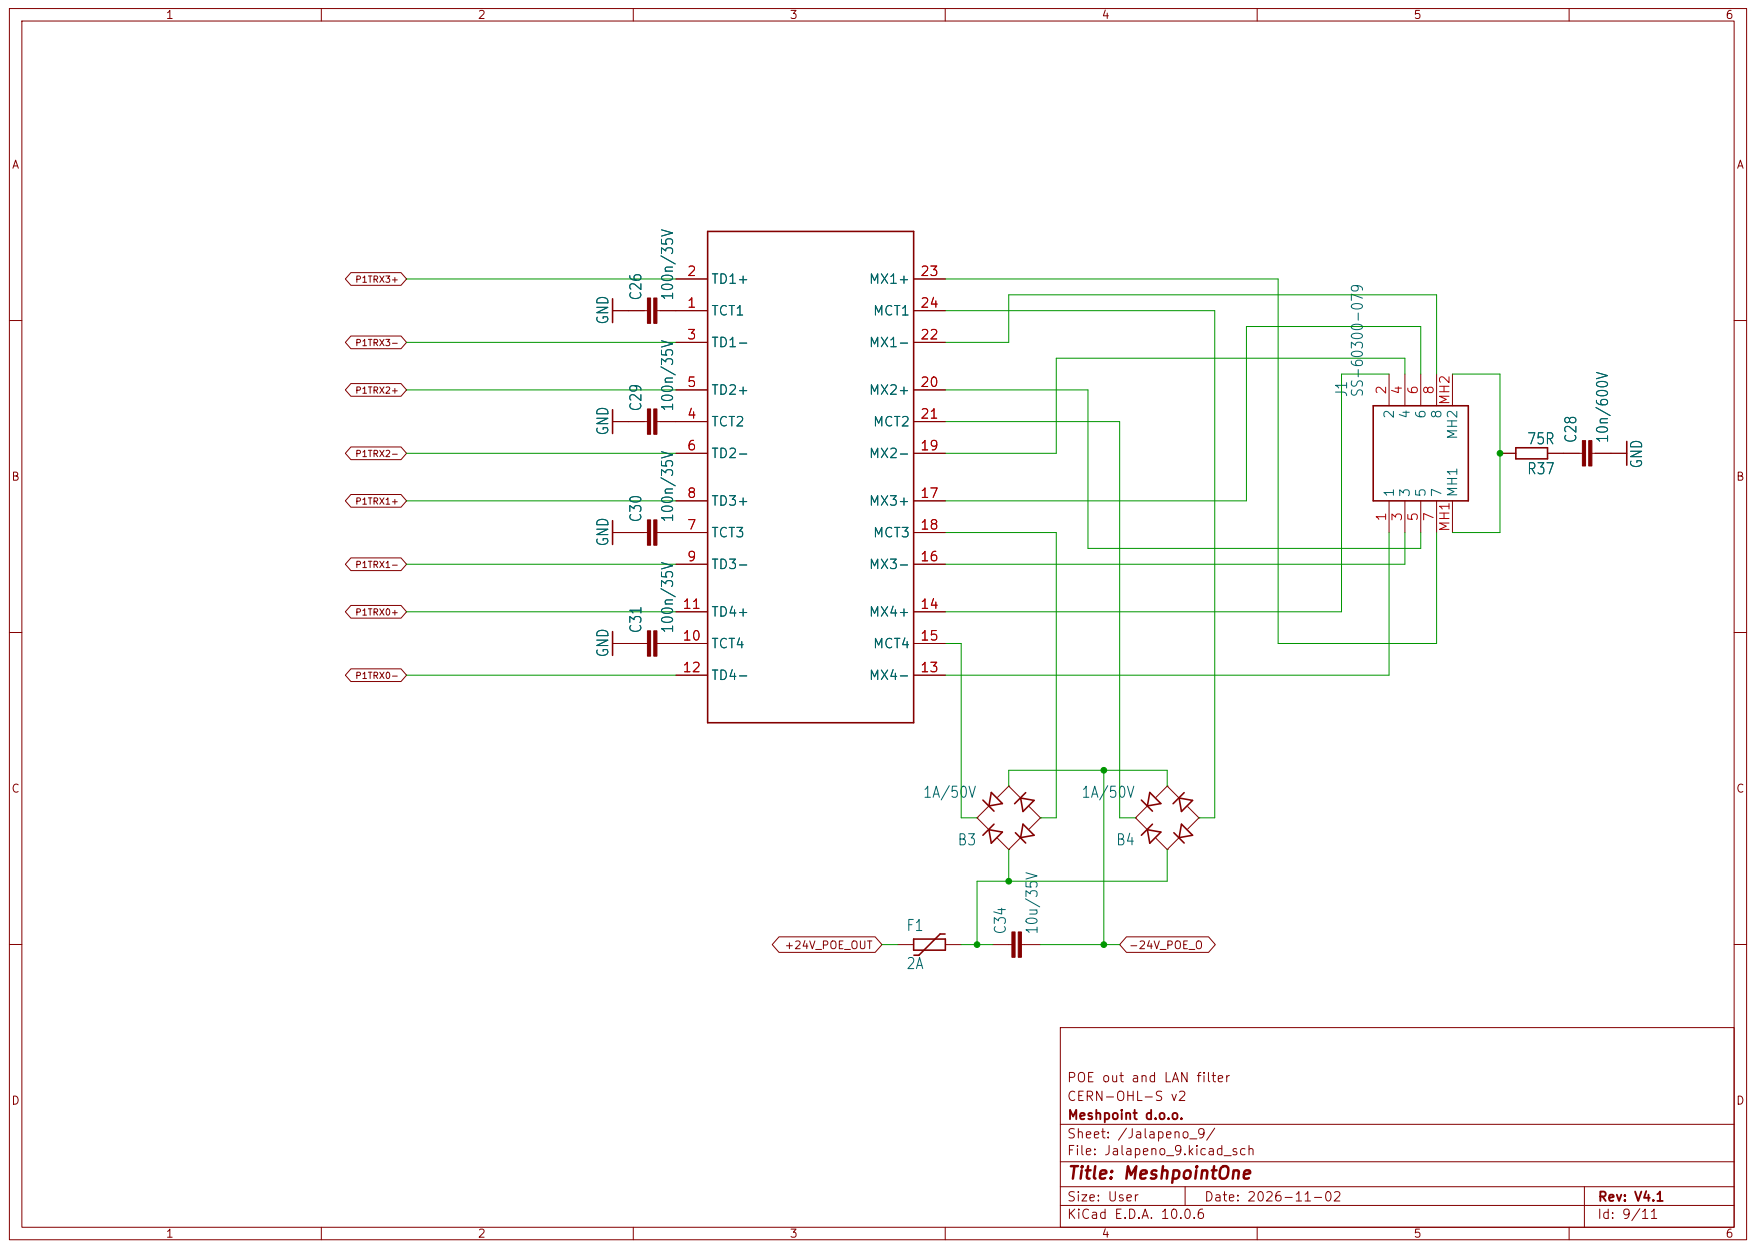
[picture p88: page 9]

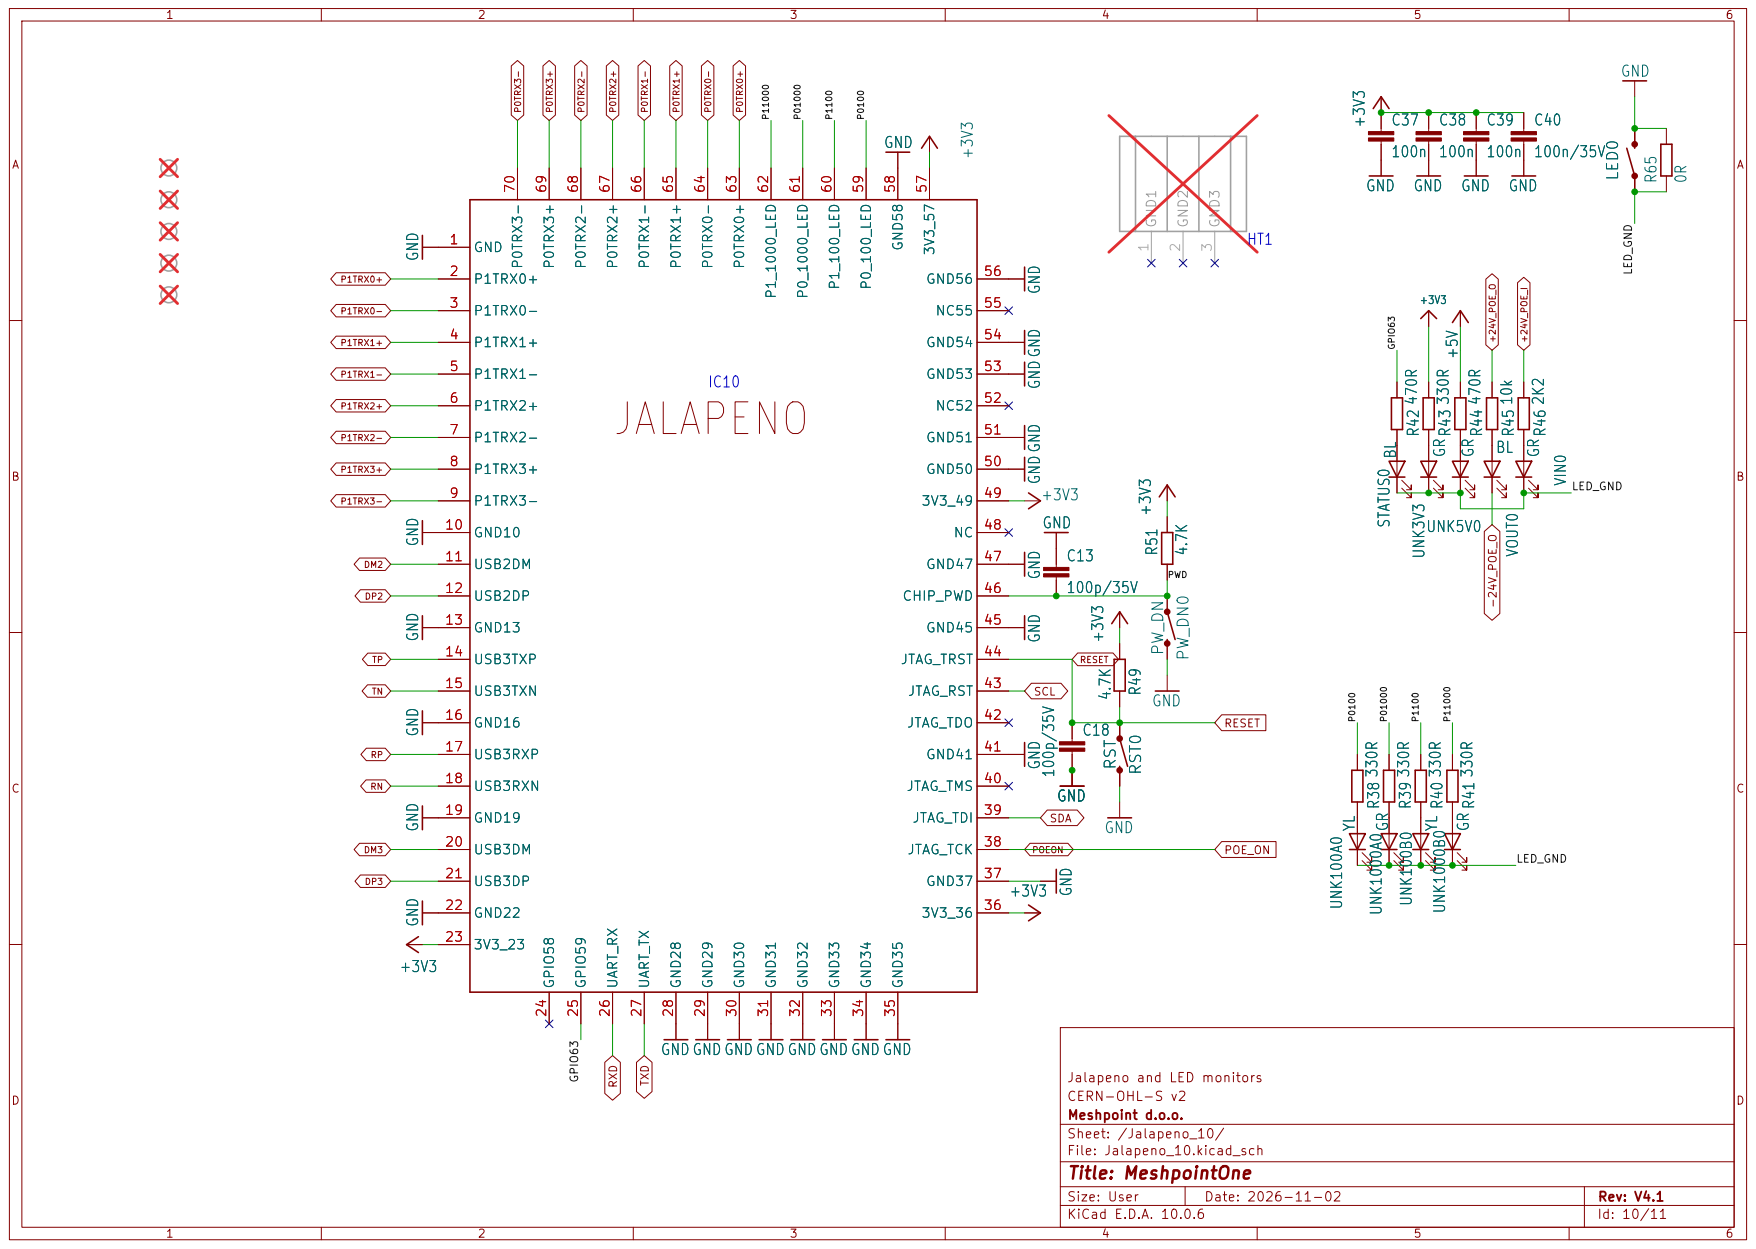
[picture p89: page 10]

P1TRX3+ 8
+3V3GND GND GND GND GND

GND GND GND GND

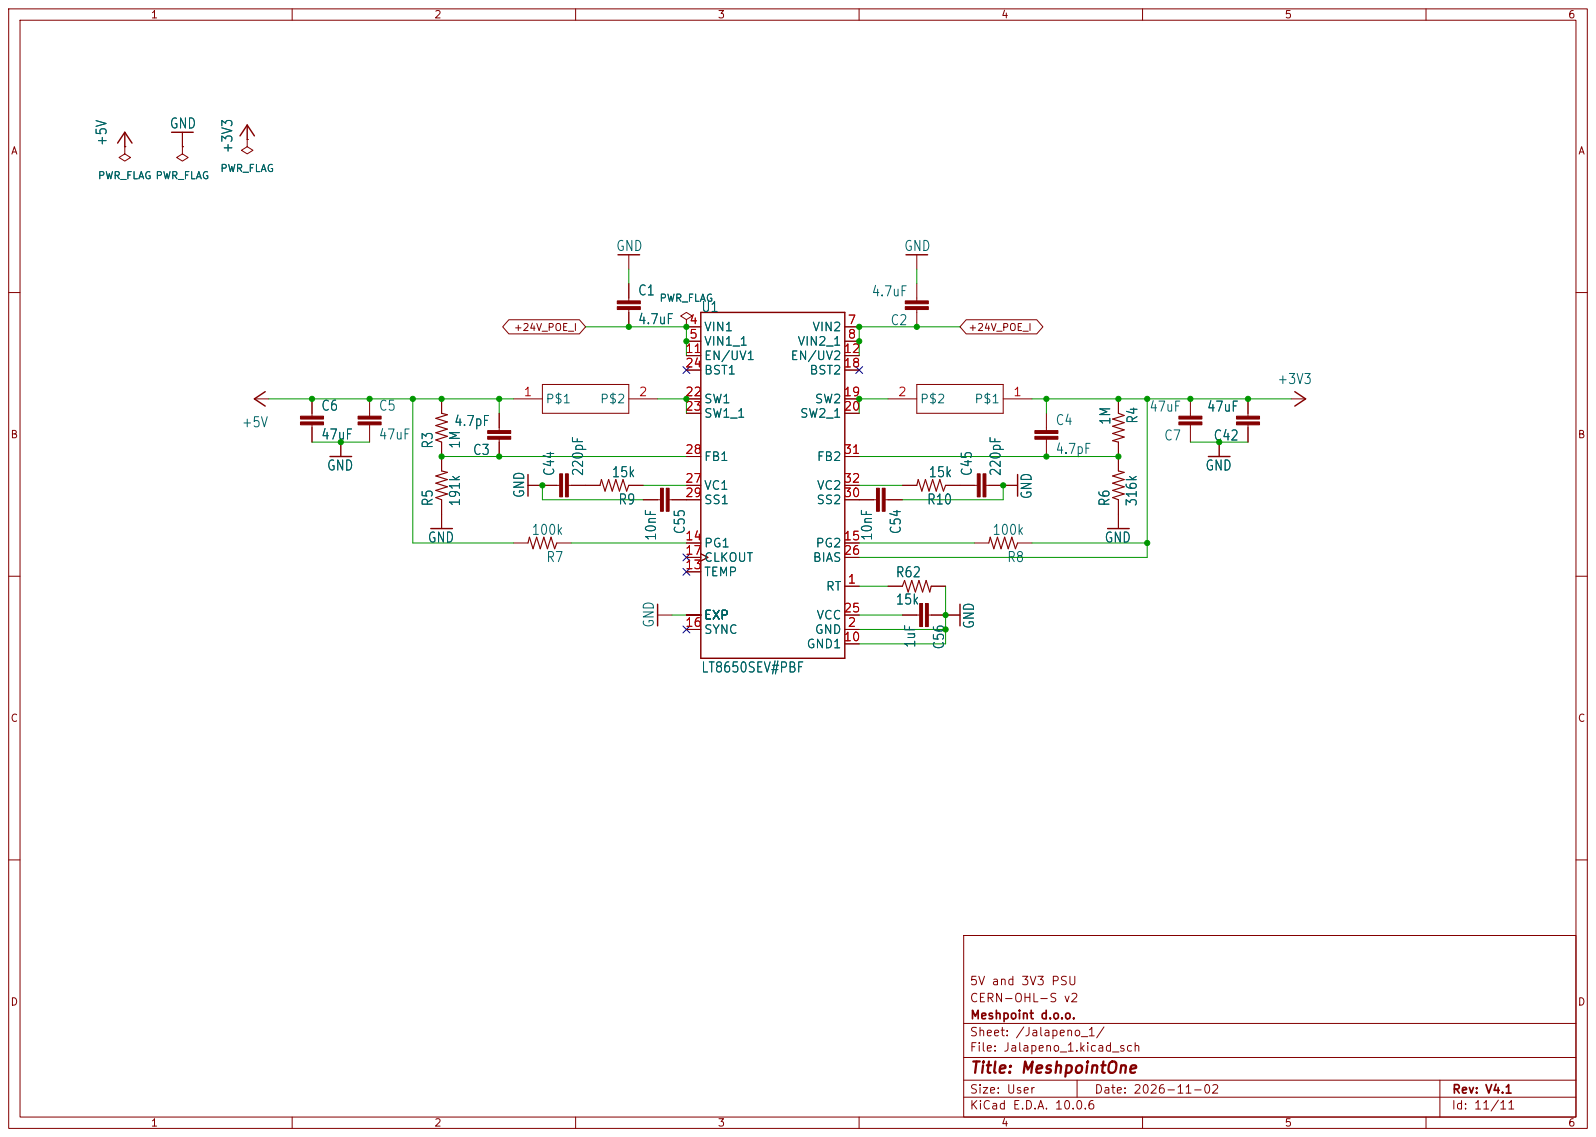
[picture p90: page 11]
