MeshPointWifi/MeshPoint/PCB/KiCad/MeshPoint.One/Jalapeno_2.kicad_sch

## KiCad design PCB/KiCad/MeshPoint.One/Jalapeno_2.kicad_sch (2026-11-02)

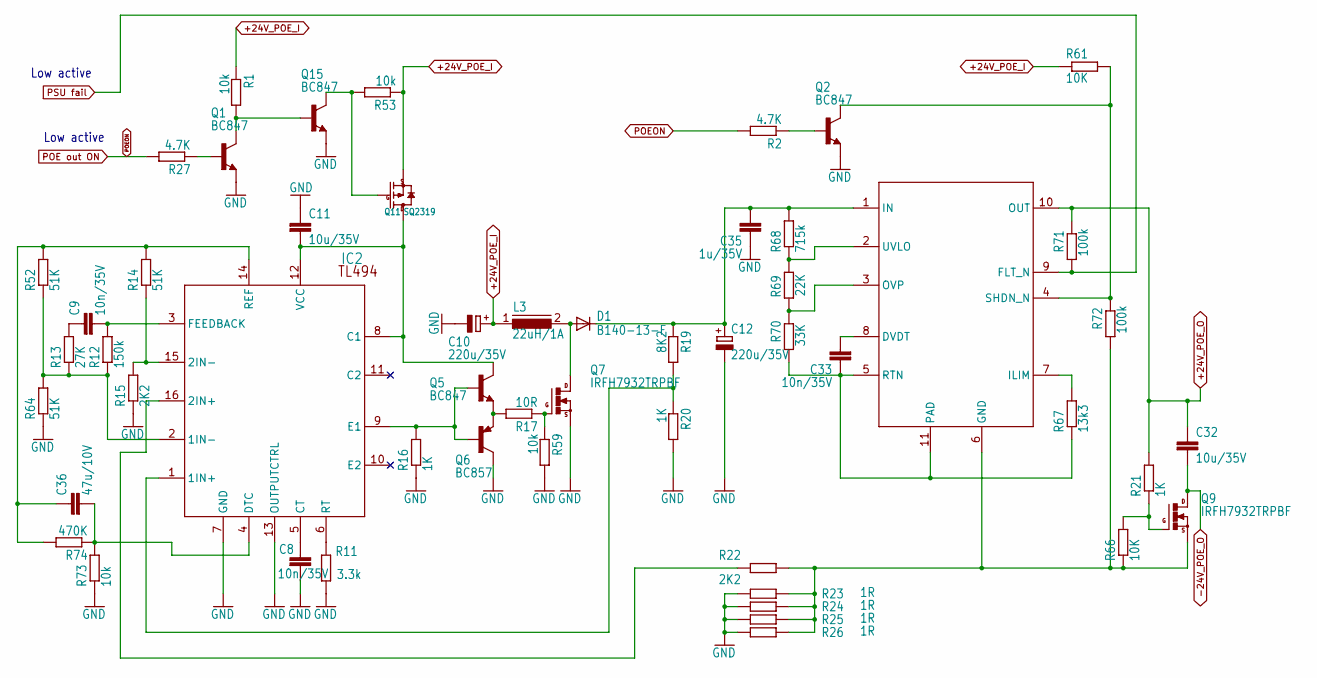
[picture p91: schematic Jalapeno_2.kicad_sch]

Parts:
C8, C9, C33: 10n/35V; C_0402_1005Metric; LCSC C1524
C10, C12: 220u/35V; 153CLV-1010; LCSC C178562
C11, C32: 10u/35V; C_1206_3216Metric; LCSC C13585
C35: 1u/35V; C_0402_1005Metric; LCSC C307413
C36: 47u/10V; C_1206_3216Metric; LCSC C5448950
D1: B140-13-F; SMB; LCSC C134426
IC2: TL494CPWR; TSSOP-16_4.4x5mm_P0.65mm; LCSC C22396897
IC11: TPS26623DRCR; Texas_DRC0010J; LCSC C2155839
L3: 22uH/1A; L_12x12mm_H6mm; LCSC C2879697
Q1, Q2, Q5, Q15: BC847; SOT-23; LCSC C8664
Q6: BC857; SOT23-BEC; LCSC C8549
Q7, Q9: IRFH7932TRPBF; PG-TDSON-8; Mouser 942-IRFH7932TRPBF
Q11: SQ2319; SOT-23; LCSC C3280190
R1, R53, R59, R73: 10k; R_0402_1005Metric; LCSC C25744
R2, R27: 4.7K; R_0402_1005Metric; LCSC C25900
R11: 3.3k; R_0402_1005Metric; LCSC C25890
R12: 150k; R_0402_1005Metric; LCSC C25755
R13: 27K; R_0402_1005Metric; LCSC C25771
R14, R52, R64: 51K; R_0402_1005Metric; LCSC C25794
R15, R22: 2K2; R_0402_1005Metric; LCSC C25879
R16, R20, R21: 1K; R_0402_1005Metric; LCSC C11702
R17: 10R; R_0402_1005Metric; LCSC C25077
R19: 8K2; R_0402_1005Metric; LCSC C137929
R23, R24, R25, R26: 1R; R_1206_3216Metric; LCSC C17928
R61, R66: 10K; R_0402_1005Metric; LCSC C25744
R67: 13k3; R_0402_1005Metric; LCSC C3015832
R68: 715k; R_0402_1005Metric; LCSC C5126240
R69: 22K; R_0402_1005Metric; LCSC C25768
R70: 33K; R_0402_1005Metric; LCSC C25779
R71, R72: 100k; R_0402_1005Metric; LCSC C25741
R74: 470K; R_0402_1005Metric; LCSC C25799

Connections:
+24V_POE_I: C10.+, L3.1, Q11.2 (S), R1.1, R53.1, R61.1
+24V_POE_O: C32.1, IC11.10 (OUT), R21.2, R71.2
-24V_POE_O: C32.2, Q9.5 (D), Q9.6 (D), Q9.7 (D), Q9.8 (D), Q9.TH (D)
GND: C8.2, C10.-, C11.1, C12.-, C35.1, IC2.7 (GND), IC2.13 (OUTPUTCTRL), Q1.2 (E), Q2.2 (E), Q6.C, Q7.1 (S), Q7.2 (S), Q7.3 (S), Q15.2 (E), R11.1, R15.1, R16.1, R20.2, R23.1, R24.1, R25.1, R26.1, R59.2, R64.1, R73.1
unnamed: C8.1, IC2.5 (CT)
unnamed: C9.1, R13.2
unnamed: C9.2, IC2.3 (FEEDBACK), R12.2
unnamed: C11.2, IC2.8 (C1), IC2.12 (VCC), Q5.3 (C), Q11.3 (D)
unnamed: C12.+, C35.2, D1.C, IC11.1 (IN), R19.1, R68.2
unnamed: C33.1, IC11.5 (RTN), IC11.11 (PAD), R67.1, R70.1
unnamed: C33.2, IC11.8 (DVDT)
unnamed: C36.1, IC2.14 (REF), R14.2, R52.2, R74.2
unnamed: C36.2, IC2.4 (DTC), R73.2, R74.1
unnamed: D1.A, L3.2, Q7.5 (D), Q7.6 (D), Q7.7 (D), Q7.8 (D), Q7.TH (D)
unnamed: IC2.1 (1IN+), R19.2, R20.1
unnamed: IC2.2 (1IN-), R12.1, R13.1, R52.1, R64.2
unnamed: IC2.6 (RT), R11.2
unnamed: IC2.9 (E1), Q5.1 (B), Q6.B, R16.2
unnamed: IC2.15 (2IN-), R14.1, R15.2
unnamed: IC2.16 (2IN+), R22.1
unnamed: IC11.2 (UVLO), R68.1, R69.2
unnamed: IC11.3 (OVP), R69.1, R70.2
unnamed: IC11.4 (SHDN_N), Q2.3 (C), R61.2, R72.2
unnamed: IC11.6 (GND), Q9.1 (S), Q9.2 (S), Q9.3 (S), R22.2, R23.2, R24.2, R25.2, R26.2, R66.1, R72.1
unnamed: IC11.7 (ILIM), R67.2
unnamed: Q1.1 (B), R27.1
unnamed: Q1.3 (C), Q15.1 (B), R1.2
unnamed: Q2.1 (B), R2.1
unnamed: Q5.2 (E), Q6.E, R17.2
unnamed: Q7.4 (G), R17.1, R59.1
unnamed: Q9.4 (G), R21.1, R66.2
unnamed: Q11.1 (G), Q15.3 (C), R53.2
POE out ON: R2.2, R27.2
PSU fail: IC11.9 (FLT_N), R71.1

Notes on the sheet:
Low active
