MeshPointWifi/MeshPoint/PCB/KiCad/MeshPoint.One/Jalapeno_3.kicad_sch

## KiCad design PCB/KiCad/MeshPoint.One/Jalapeno_3.kicad_sch (2026-11-02)

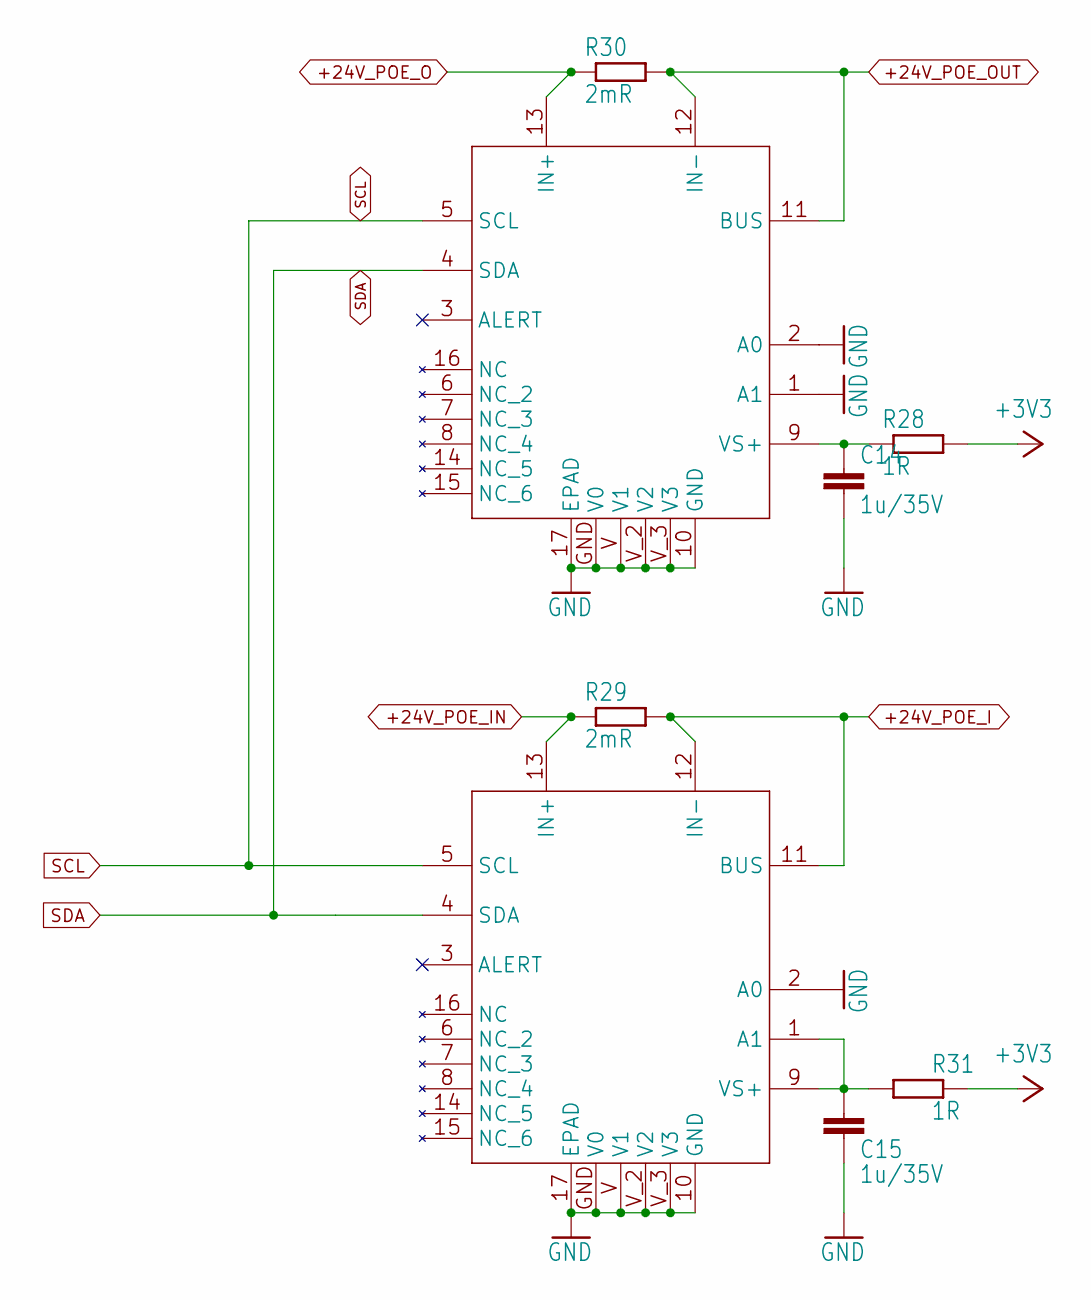
[picture p92: schematic Jalapeno_3.kicad_sch]

Parts:
C14, C15: 1u/35V; C_0402_1005Metric; LCSC C307413
IC3, IC4: INA230_RGT_16; QFN-16-1EP_3x3mm_P0.5mm_EP1.7x1.7mm; LCSC C882784
R28, R31: 1R; R_0402_1005Metric; LCSC C25086
R29, R30: 2mR; R_2010_5025Metric; LCSC C844078

Connections:
+3V3: R28.2, R31.2
+24V_POE_I: IC4.11 (BUS), IC4.12 (IN-), R29.2
+24V_POE_IN: IC4.13 (IN+), R29.1
+24V_POE_O: IC3.13 (IN+), R30.1
+24V_POE_OUT: IC3.11 (BUS), IC3.12 (IN-), R30.2
GND: C14.2, C15.2, IC3.1 (A1), IC3.2 (A0), IC3.10 (GND), IC3.17 (EPAD), IC3.GND (V0), IC3.V (V1), IC3.V_2 (V2), IC3.V_3 (V3), IC4.2 (A0), IC4.10 (GND), IC4.17 (EPAD), IC4.GND (V0), IC4.V (V1), IC4.V_2 (V2), IC4.V_3 (V3)
unnamed: C14.1, IC3.9 (VS+), R28.1
unnamed: C15.1, IC4.1 (A1), IC4.9 (VS+), R31.1
SCL: IC3.5 (SCL), IC4.5 (SCL)
SDA: IC3.4 (SDA), IC4.4 (SDA)
