MeshPointWifi/MeshPoint/PCB/KiCad/MeshPoint.One/Jalapeno_4.kicad_sch

## KiCad design PCB/KiCad/MeshPoint.One/Jalapeno_4.kicad_sch (2026-11-02)

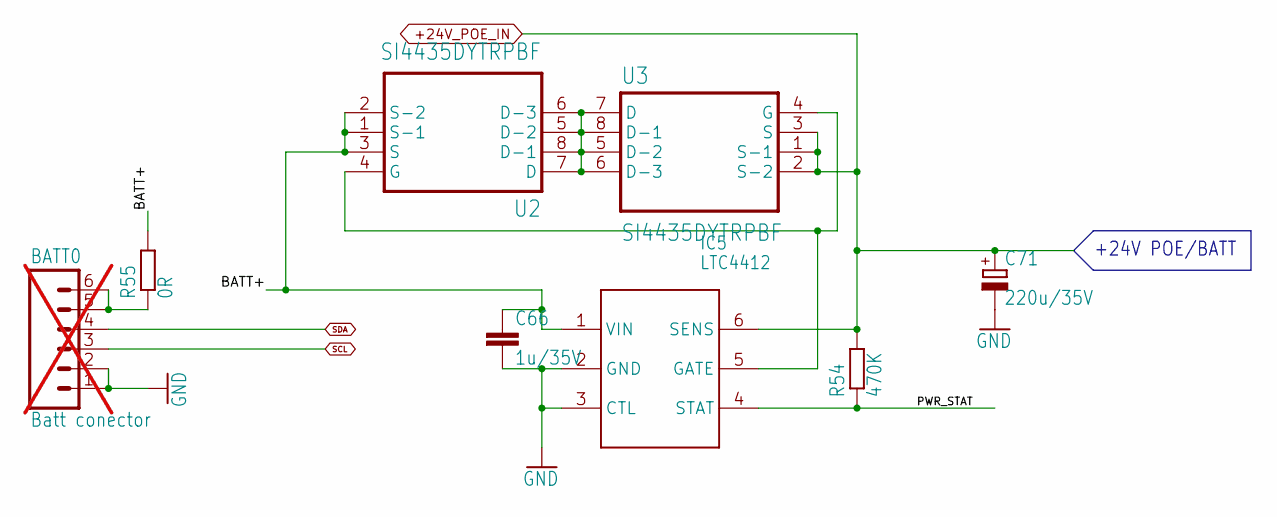
[picture p93: schematic Jalapeno_4.kicad_sch]

Parts:
BATT0: Batt conector; 06P; LCSC C87216; not fitted
C66: 1u/35V; C_0402_1005Metric; LCSC C307413
C71: 220u/35V; 153CLV-1010; LCSC C178562
IC5: LTC4412; TSOT-23-6; LCSC C514442
R54: 470K; R_0402_1005Metric; LCSC C25799
R55: 0R; R_0805_2012Metric; LCSC C17477
U2, U3: SI4435DYTRPBF; SOIC-8_3.9x4.9mm_P1.27mm; LCSC C67287

Connections:
+24V_POE_IN: C71.+, IC5.6 (SENS), R54.2, U3.1 (S-1), U3.2 (S-2), U3.3 (S)
BATT+: C66.1, IC5.1 (VIN), R55.2, U2.1 (S-1), U2.2 (S-2), U2.3 (S)
GND: BATT0.1, BATT0.2, C66.2, C71.-, IC5.2 (GND), IC5.3 (CTL)
unnamed: BATT0.5, BATT0.6, R55.1
unnamed: IC5.5 (GATE), U2.4 (G), U3.4 (G)
unnamed: U2.5 (D-2), U2.6 (D-3), U2.7 (D), U2.8 (D-1), U3.5 (D-2), U3.6 (D-3), U3.7 (D), U3.8 (D-1)
PWR_STAT: IC5.4 (STAT), R54.1
SCL: BATT0.3
SDA: BATT0.4

Notes on the sheet:
+24V POE/BATT
