MeshPointWifi/MeshPoint/PCB/KiCad/MeshPoint.One/Jalapeno_5.kicad_sch

## KiCad design PCB/KiCad/MeshPoint.One/Jalapeno_5.kicad_sch (2026-11-02)

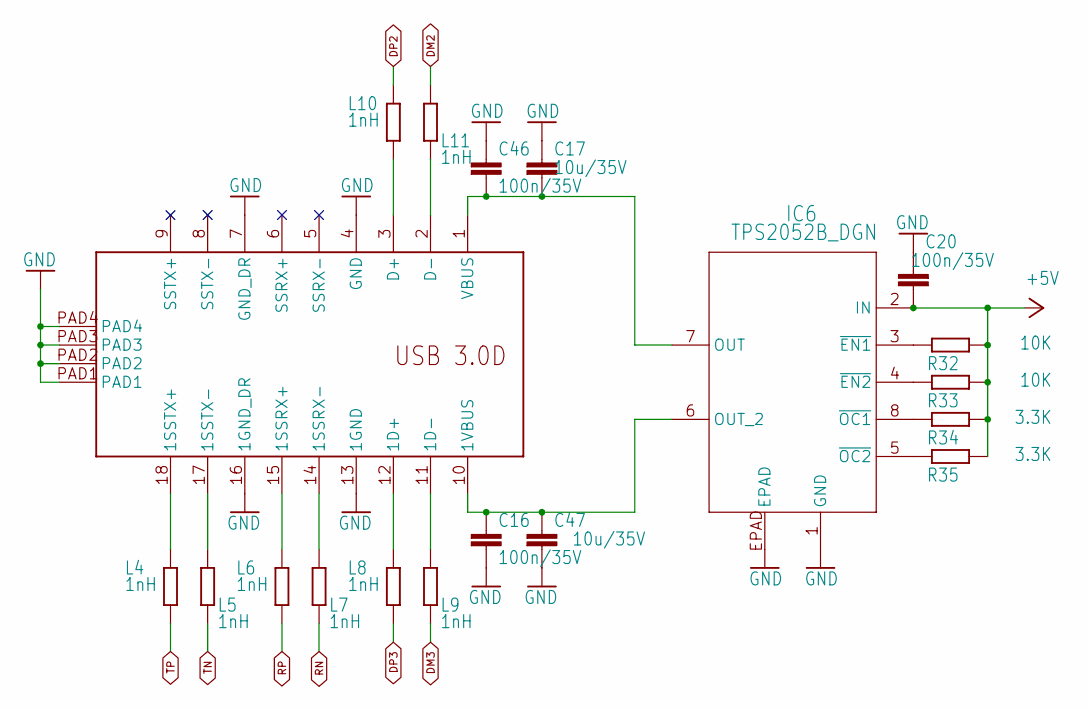
[picture p94: schematic Jalapeno_5.kicad_sch]

Parts:
C16, C20, C46: 100n/35V; C_0402_1005Metric; LCSC C187828
C17, C47: 10u/35V; C_1206_3216Metric; LCSC C13585
IC6: TPS2052B_DGN; DGN8_1P89X1P57; LCSC C2879167
L4, L5, L6, L7, L8, L9, L10, L11: 1nH; R_0402_1005Metric; LCSC C19633897
R32, R33: 10K; R_0402_1005Metric; LCSC C25744
R34, R35: 3.3K; R_0402_1005Metric; LCSC C25890
USB3.0: USB3.0D; Mouser 530-SS-52000-003

Connections:
+5V: C20.2, IC6.2 (IN), R32.1, R33.1, R34.1, R35.1
DM2: L11.1
DM3: L9.2
DP2: L10.1
DP3: L8.2
GND: C16.2, C17.1, C20.1, C46.1, C47.2, IC6.1 (GND), IC6.EPAD, USB3.0.4 (GND), USB3.0.7 (GND_DR), USB3.0.13 (1GND), USB3.0.16 (1GND_DR), USB3.0.PAD1, USB3.0.PAD2, USB3.0.PAD3, USB3.0.PAD4
unnamed: C16.1, C47.1, IC6.6 (OUT_2), USB3.0.10 (1VBUS)
unnamed: C17.2, C46.2, IC6.7 (OUT), USB3.0.1 (VBUS)
unnamed: IC6.3 (~EN1), R32.2
unnamed: IC6.4 (~EN2), R33.2
unnamed: IC6.5 (~OC2), R35.2
unnamed: IC6.8 (~OC1), R34.2
unnamed: L4.1, USB3.0.18 (1SSTX+)
unnamed: L5.1, USB3.0.17 (1SSTX-)
unnamed: L6.1, USB3.0.15 (1SSRX+)
unnamed: L7.1, USB3.0.14 (1SSRX-)
unnamed: L8.1, USB3.0.12 (1D+)
unnamed: L9.1, USB3.0.11 (1D-)
unnamed: L10.2, USB3.0.3 (D+)
unnamed: L11.2, USB3.0.2 (D-)
RN: L7.2
RP: L6.2
TN: L5.2
TP: L4.2
