MeshPointWifi/MeshPoint/PCB/KiCad/MeshPoint.One/Jalapeno_6.kicad_sch

## KiCad design PCB/KiCad/MeshPoint.One/Jalapeno_6.kicad_sch (2026-11-02)

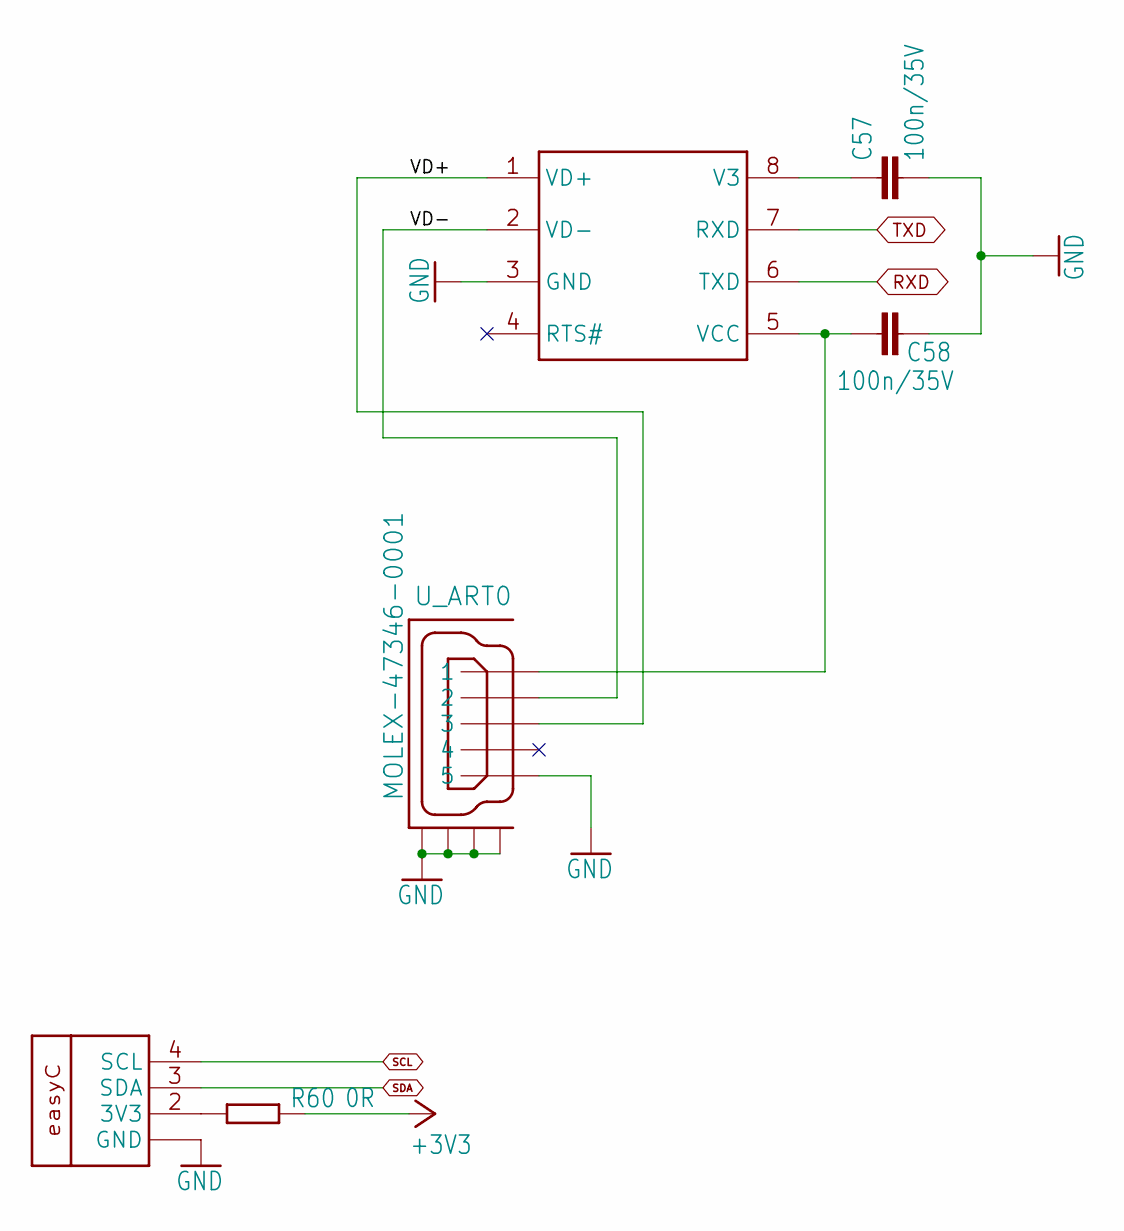
[picture p95: schematic Jalapeno_6.kicad_sch]

Parts:
C57, C58: 100n/35V; C_0402_1005Metric; LCSC C187828
CN2: EASYC; LCSC C160404
IC10: CH340N; SOIC-8_3.9x4.9mm_P1.27mm; LCSC C2977777
R60: 0R; R_0805_2012Metric; LCSC C17477
U_ART0: MOLEX-47346-0001; MOLEX-47364-0001; LCSC C232975

Connections:
+3V3: R60.2
GND: C57.2, C58.2, CN2.1 (GND), CN2.NC1 (GND), CN2.NC2 (GND), IC10.3 (GND), U_ART0.5, U_ART0.GND1, U_ART0.GND2, U_ART0.GND3, U_ART0.GND4
unnamed: C57.1, IC10.8 (V3)
unnamed: C58.1, IC10.5 (VCC), U_ART0.1
unnamed: CN2.2 (3V3), R60.1
RXD: IC10.6 (TXD)
SCL: CN2.4 (SCL)
SDA: CN2.3 (SDA)
TXD: IC10.7 (RXD)
VD+: IC10.1 (VD+), U_ART0.3
VD-: IC10.2 (VD-), U_ART0.2
