MeshPointWifi/MeshPoint/PCB/KiCad/MeshPoint.One/Jalapeno_7.kicad_sch

## KiCad design PCB/KiCad/MeshPoint.One/Jalapeno_7.kicad_sch (2026-11-02)

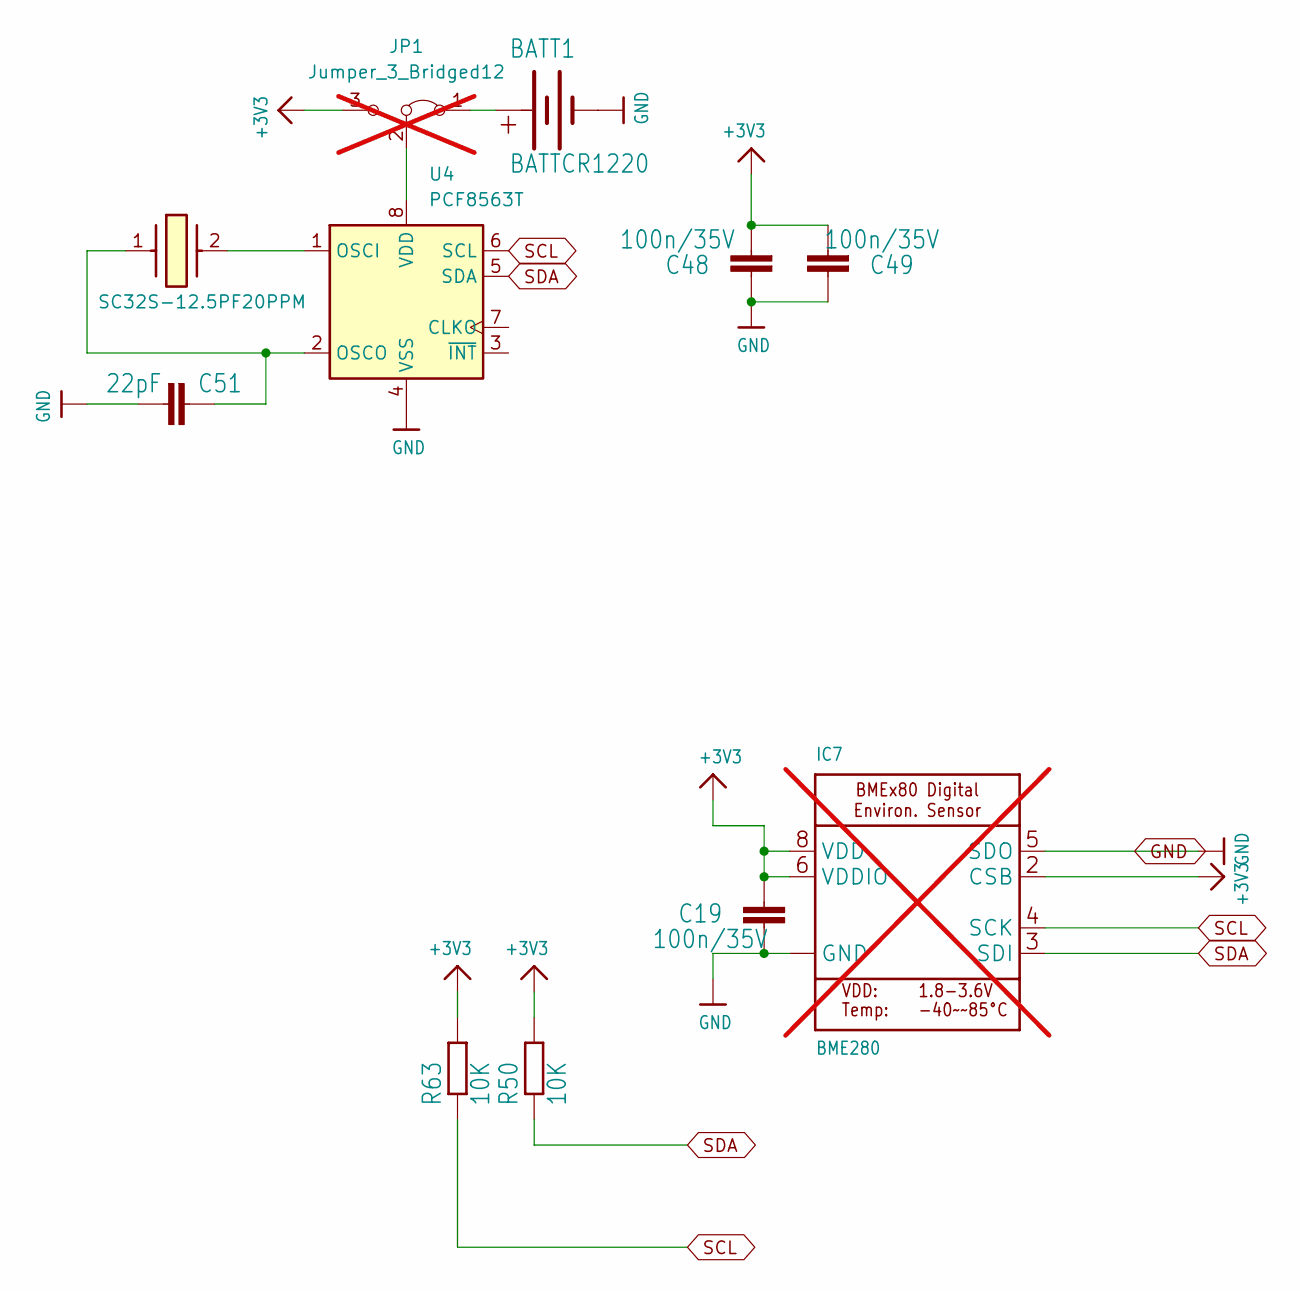
[picture p96: schematic Jalapeno_7.kicad_sch]

Parts:
BATT1: BATTCR1220; BATERIJA12MM; LCSC C70377
C19, C48, C49: 100n/35V; C_0402_1005Metric; LCSC C187828
C51: 22pF; C_0402_1005Metric; LCSC C1555
IC7: BME280; Bosch_LGA-8_2.5x2.5mm_P0.65mm_ClockwisePinNumbering; LCSC C92489; not fitted
JP1: Jumper_3_Bridged12; SolderJumper-3_P1.3mm_Open_RoundedPad1.0x1.5mm_NumberLabels; not fitted
R50, R63: 10K; R_0402_1005Metric; LCSC C25744
U4: PCF8563T; SOIC-8_3.9x4.9mm_P1.27mm; LCSC C7440
Y1: SC32S-12.5PF20PPM; SC32S125PF20PPM; Mouser Part Number 628-SC32S-125PF20PPM

Connections:
+3V3: C19.1, C48.2, C49.2, IC7.2 (CSB), IC7.6 (VDDIO), IC7.8 (VDD), JP1.3 (B), R50.2, R63.2
GND: BATT1.-, C19.2, C48.1, C49.1, C51.2, IC7.1 (GND), IC7.5 (SDO), IC7.7 (GND), U4.4 (VSS)
unnamed: BATT1.+, JP1.1 (A)
unnamed: C51.1, U4.2 (OSCO), Y1.1
unnamed: JP1.2 (C), U4.8 (VDD)
unnamed: U4.1 (OSCI), Y1.2
SCL: IC7.4 (SCK), R63.1, U4.6 (SCL)
SDA: IC7.3 (SDI), R50.1, U4.5 (SDA)
