MeshPointWifi/MeshPoint/PCB/KiCad/MeshPoint.One/Jalapeno_9.kicad_sch

## KiCad design PCB/KiCad/MeshPoint.One/Jalapeno_9.kicad_sch (2026-11-02)

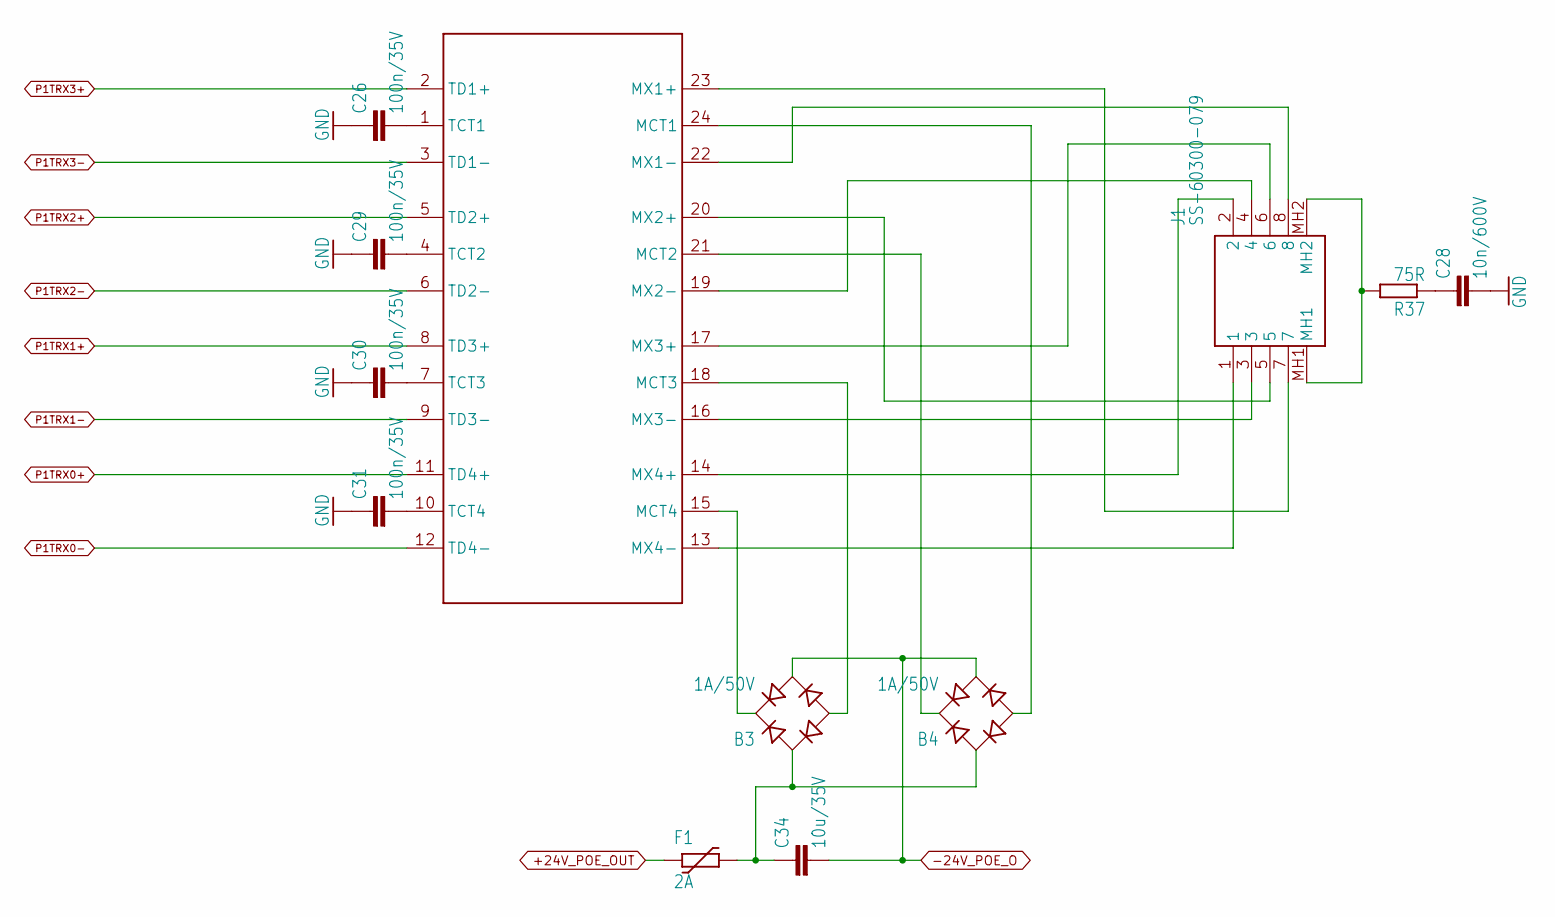
[picture p97: schematic Jalapeno_9.kicad_sch]

Parts:
B3, B4: 1A/50V; MBS; LCSC C2488
C26, C29, C30, C31: 100n/35V; C_0402_1005Metric; LCSC C187828
C28: 10n/600V; C_1206_3216Metric; LCSC C107201
C34: 10u/35V; C_1206_3216Metric; LCSC C13585
F1: 2A; Fuse_1812_4532Metric; LCSC C70124
J1: SS-60300-079; SS60300079; LCSC C402283
R37: 75R; R_1206_3216Metric; LCSC C17987
TR2: WURTH_TR; WURTH1000T; LCSC C6828534

Connections:
+24V_POE_OUT: F1.1
-24V_POE_O: B3.AC2, B4.AC2, C34.2
GND: C26.1, C28.2, C29.1, C30.1, C31.1
unnamed: B3.+, TR2.15 (MCT4)
unnamed: B3.-, TR2.18 (MCT3)
unnamed: B3.AC1, B4.AC1, C34.1, F1.2
unnamed: B4.+, TR2.21 (MCT2)
unnamed: B4.-, TR2.24 (MCT1)
unnamed: C26.2, TR2.1 (TCT1)
unnamed: C28.1, R37.1
unnamed: C29.2, TR2.4 (TCT2)
unnamed: C30.2, TR2.7 (TCT3)
unnamed: C31.2, TR2.10 (TCT4)
unnamed: J1.1, TR2.13 (MX4-)
unnamed: J1.2, TR2.14 (MX4+)
unnamed: J1.3, TR2.16 (MX3-)
unnamed: J1.4, TR2.19 (MX2-)
unnamed: J1.5, TR2.20 (MX2+)
unnamed: J1.6, TR2.17 (MX3+)
unnamed: J1.7, TR2.23 (MX1+)
unnamed: J1.8, TR2.22 (MX1-)
unnamed: J1.MH1, J1.MH2, R37.2
P1TRX0+: TR2.11 (TD4+)
P1TRX0-: TR2.12 (TD4-)
P1TRX1+: TR2.8 (TD3+)
P1TRX1-: TR2.9 (TD3-)
P1TRX2+: TR2.5 (TD2+)
P1TRX2-: TR2.6 (TD2-)
P1TRX3+: TR2.2 (TD1+)
P1TRX3-: TR2.3 (TD1-)
