MeshPointWifi/MeshPoint/PCB/KiCad/MeshPoint.One/Jalapeno_10.kicad_sch

## KiCad design PCB/KiCad/MeshPoint.One/Jalapeno_10.kicad_sch (2026-11-02)

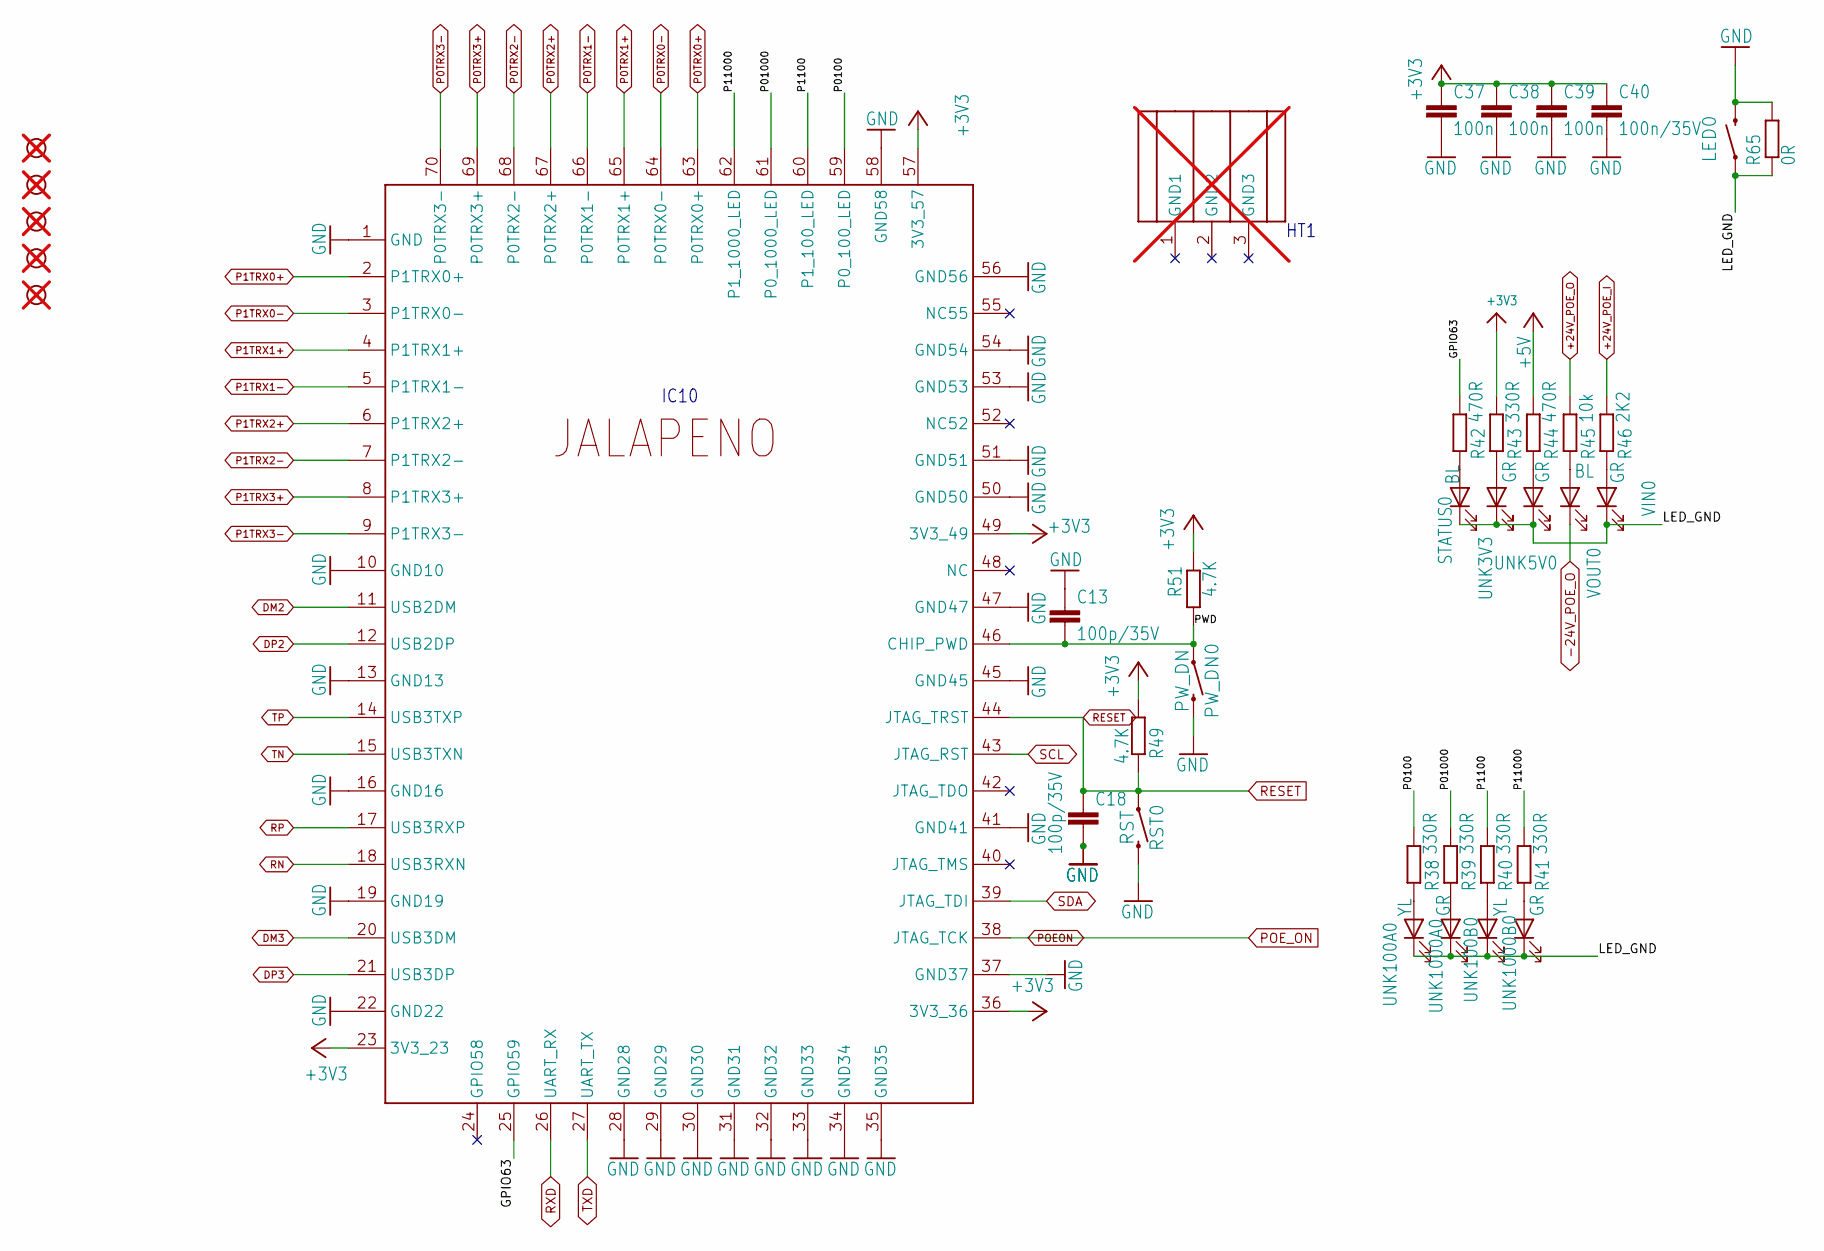
[picture p98: schematic Jalapeno_10.kicad_sch]

Parts:
C13, C18: 100p/35V; C_0402_1005Metric; LCSC C1546
C37, C38, C39: 100n; C_0402_1005Metric; LCSC C187828
C40: 100n/35V; C_0402_1005Metric; LCSC C187828
FD1, FD2, FD3, FD4, FD5: FIDUCIALUFIDUCIAL; FIDUCIAL-MICRO_507; not fitted
LED0: MOMENTARY-SWITCH-SPST-SMD-4.6X2.8MM; TACTILE_SWITCH_SMD_4.6X2.8MM_535; LCSC C72443
PW_DN0: PW_DN; TACTILE_SWITCH_SMD_4.6X2.8MM_535; LCSC C72443
R38, R39, R40, R41, R43: 330R; R_0402_1005Metric; LCSC C25104
R42, R44: 470R; R_0402_1005Metric; LCSC C25117
R45: 10k; R_0402_1005Metric; LCSC C25744
R46: 2K2; R_0402_1005Metric; LCSC C25879
R49, R51: 4.7K; R_0402_1005Metric; LCSC C25900
R65: 0R; R_0805_2012Metric; LCSC C17477
RST0: RST; TACTILE_SWITCH_SMD_4.6X2.8MM_535; LCSC C72443
STATUS0: BL; LED_0603_1608Metric; LCSC C2288
U$5: JALAPENO; JALAPENO-PCB
U$9: HEATSINK; not fitted
UNK3V3, UNK5V0, UNK1000A0, UNK1000B0: GR; LED_0603_1608Metric; LCSC C72043
UNK100A0, UNK100B0: YL; LED_0603_1608Metric; LCSC C72038
VIN0: GR; LED_0603_1608Metric; LCSC C72043
VOUT0: BL; LED_0603_1608Metric; LCSC C2288

Connections:
+3V3: C37.1, C38.1, C39.1, C40.1, R43.2, R49.1, R51.2, U$5.23 (3V3_23), U$5.36 (3V3_36), U$5.49 (3V3_49), U$5.57 (3V3_57)
+5V: R44.2
+24V_POE_I: R46.2
+24V_POE_O: R45.2
-24V_POE_O: VOUT0.1 (K)
DM2: U$5.11 (USB2DM)
DM3: U$5.20 (USB3DM)
DP2: U$5.12 (USB2DP)
DP3: U$5.21 (USB3DP)
GND: C13.1, C18.2, C37.2, C38.2, C39.2, C40.2, LED0.3 (2), LED0.4 (2), PW_DN0.3 (2), PW_DN0.4 (2), R65.2, RST0.3 (2), RST0.4 (2), U$5.1 (GND), U$5.10 (GND10), U$5.13 (GND13), U$5.16 (GND16), U$5.19 (GND19), U$5.22 (GND22), U$5.28 (GND28), U$5.29 (GND29), U$5.30 (GND30), U$5.31 (GND31), U$5.32 (GND32), U$5.33 (GND33), U$5.34 (GND34), U$5.35 (GND35), U$5.37 (GND37), U$5.41 (GND41), U$5.45 (GND45), U$5.47 (GND47), U$5.50 (GND50), U$5.51 (GND51), U$5.53 (GND53), U$5.54 (GND54), U$5.56 (GND56), U$5.58 (GND58)
GPIO63: R42.2, U$5.25 (GPIO59)
LED_GND: LED0.1, LED0.2 (1), R65.1, STATUS0.1 (K), UNK3V3.1 (K), UNK5V0.1 (K), UNK100A0.1 (K), UNK100B0.1 (K), UNK1000A0.1 (K), UNK1000B0.1 (K), VIN0.1 (K)
unnamed: R38.1, UNK100A0.2 (A)
unnamed: R39.1, UNK1000A0.2 (A)
unnamed: R40.1, UNK100B0.2 (A)
unnamed: R41.1, UNK1000B0.2 (A)
unnamed: R42.1, STATUS0.2 (A)
unnamed: R43.1, UNK3V3.2 (A)
unnamed: R44.1, UNK5V0.2 (A)
unnamed: R45.1, VOUT0.2 (A)
unnamed: R46.1, VIN0.2 (A)
P0TRX0+: U$5.63 (P0TRX0+)
P0TRX0-: U$5.64 (P0TRX0-)
P0TRX1+: U$5.65 (P0TRX1+)
P0TRX1-: U$5.66 (P0TRX1-)
P0TRX2+: U$5.67 (P0TRX2+)
P0TRX2-: U$5.68 (P0TRX2-)
P0TRX3+: U$5.69 (P0TRX3+)
P0TRX3-: U$5.70 (P0TRX3-)
P1TRX0+: U$5.2 (P1TRX0+)
P1TRX0-: U$5.3 (P1TRX0-)
P1TRX1+: U$5.4 (P1TRX1+)
P1TRX1-: U$5.5 (P1TRX1-)
P1TRX2+: U$5.6 (P1TRX2+)
P1TRX2-: U$5.7 (P1TRX2-)
P1TRX3+: U$5.8 (P1TRX3+)
P1TRX3-: U$5.9 (P1TRX3-)
P0100: R38.2, U$5.59 (P0_100_LED)
P01000: R39.2, U$5.61 (P0_1000_LED)
P1100: R40.2, U$5.60 (P1_100_LED)
P11000: R41.2, U$5.62 (P1_1000_LED)
POE_ON: U$5.38 (JTAG_TCK)
PWD: C13.2, PW_DN0.1, PW_DN0.2 (1), R51.1, U$5.46 (CHIP_PWD)
RESET: C18.1, R49.2, RST0.1, RST0.2 (1), U$5.44 (JTAG_TRST)
RN: U$5.18 (USB3RXN)
RP: U$5.17 (USB3RXP)
RXD: U$5.26 (UART_RX)
SCL: U$5.43 (JTAG_RST)
SDA: U$5.39 (JTAG_TDI)
TN: U$5.15 (USB3TXN)
TP: U$5.14 (USB3TXP)
TXD: U$5.27 (UART_TX)

Notes on the sheet:
HT1
IC10
