MeshPointWifi/MeshPoint/(commit log)

2017-01-27 renamed stl files
2017-06-12 Removed nuts used for assembly, decreased hole diameter, reduced size of some parts for better fit.
2026-07-06 Reorganize photos into categorized folders + add PCB files, prototype photos, media coverage
    - Photos organized: Prototype V1/V2, Media coverage, UNICEF humanitarian award, Refugee Center Zagreb (2016)
    - PCB/ design files added
    - meshpoint_transparent.png
    - Note: IMG_4798.MOV (109MB) excluded — exceeds GitHub 100MB file limit
2026-07-06 Add more photos: Techfugees London 2016, Prototype V1
2026-11-02 Schematic update - adding info and pictures
